agben/Hol-1/ALU/Hol-1-ALU-pcb-v1-0.png

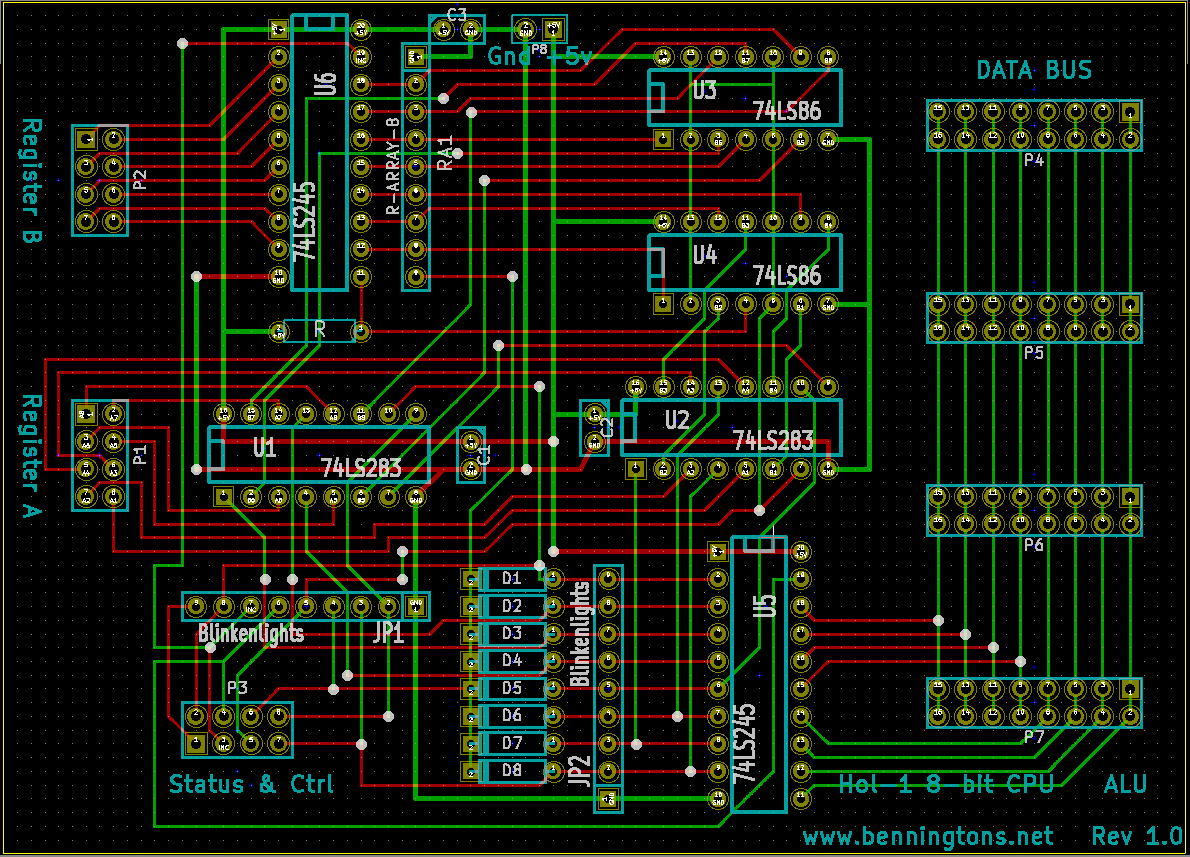
ALU/Hol-1-ALU-pcb-v1-0.png
