agben/Hol-1/MMU/Hol-1-MMU-pcb-v1-0.png

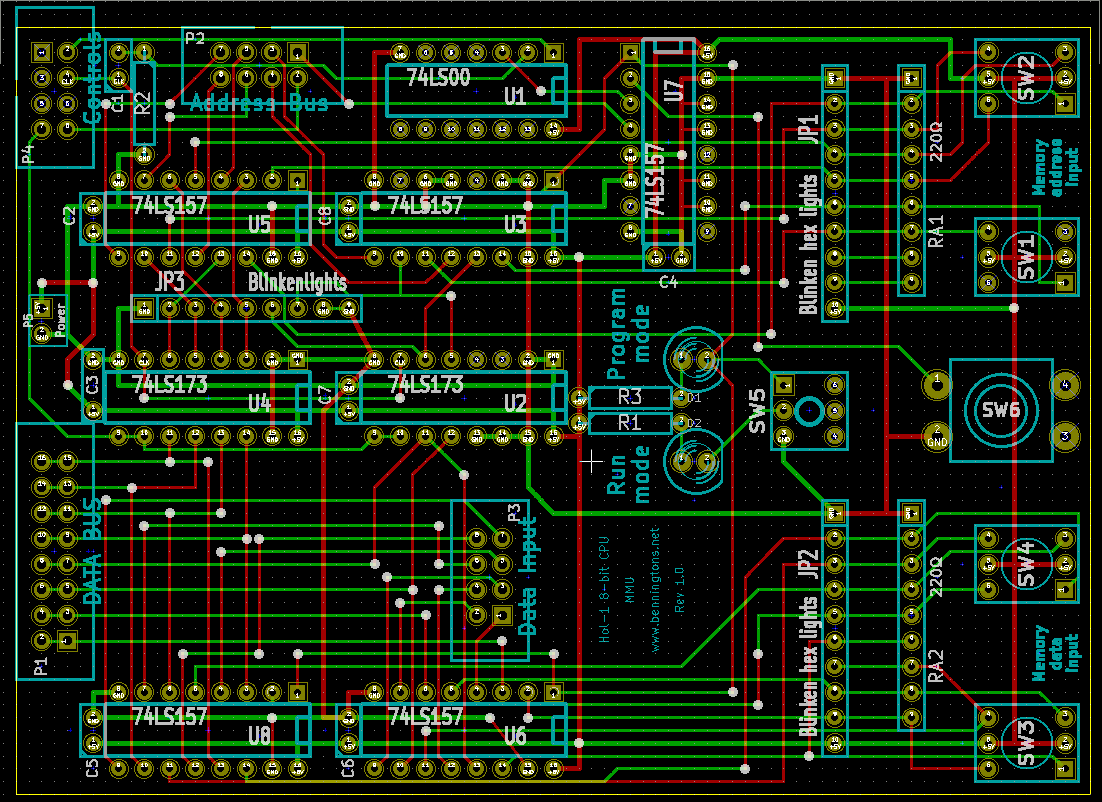
MMU/Hol-1-MMU-pcb-v1-0.png
