agben/Hol-1/RAM/Hol-1-RAM-pcb-v1-0.png

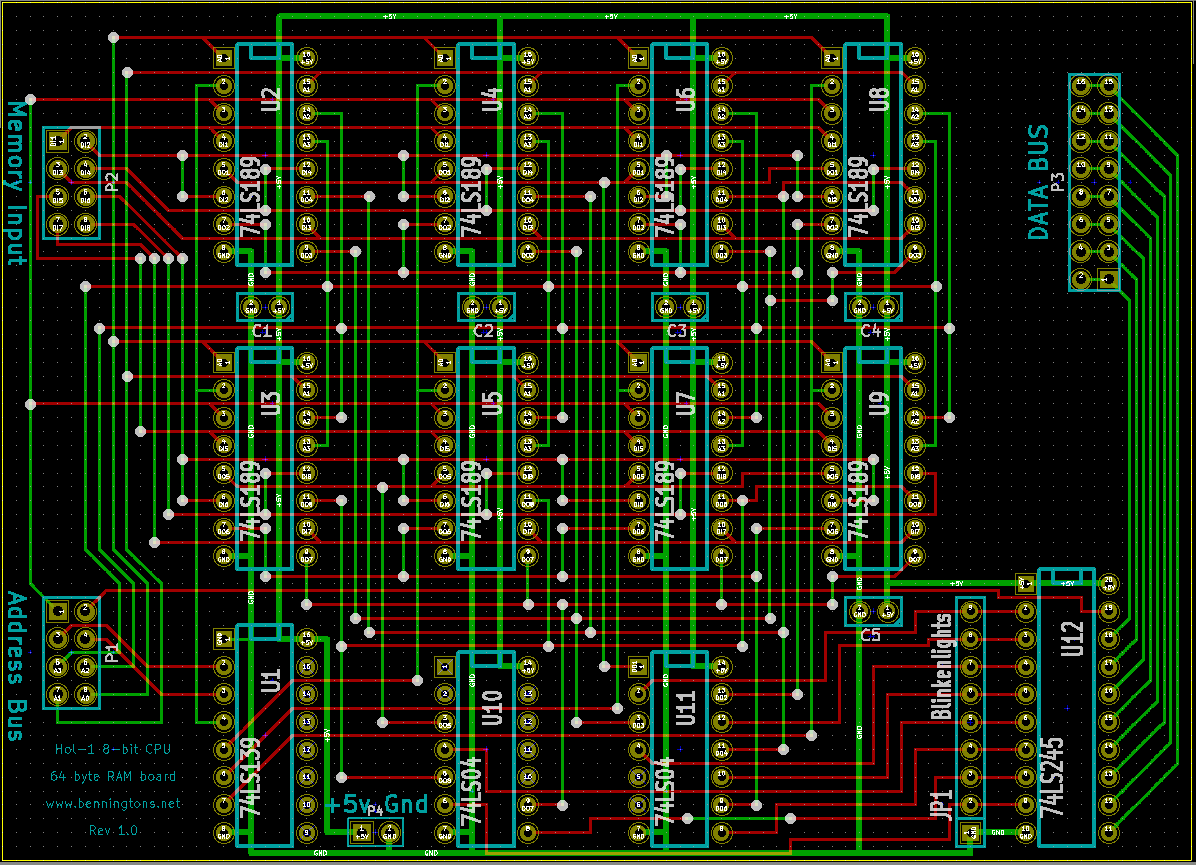
RAM/Hol-1-RAM-pcb-v1-0.png
