agben/Hol-1/RAM/Hol-1-RAM-sch-v1-0.png

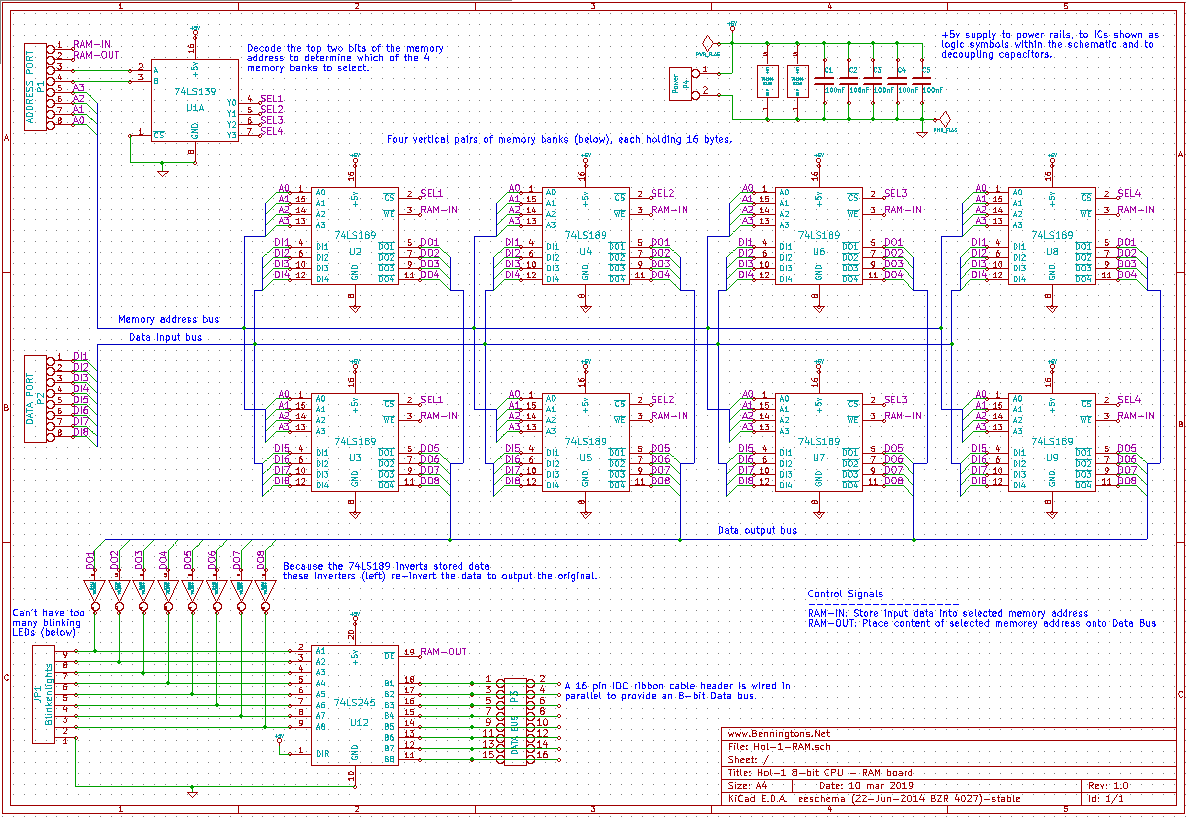
RAM/Hol-1-RAM-sch-v1-0.png
