agben/Hol-1/Registers/Hol-1-Reg-pcb-v1-0.png

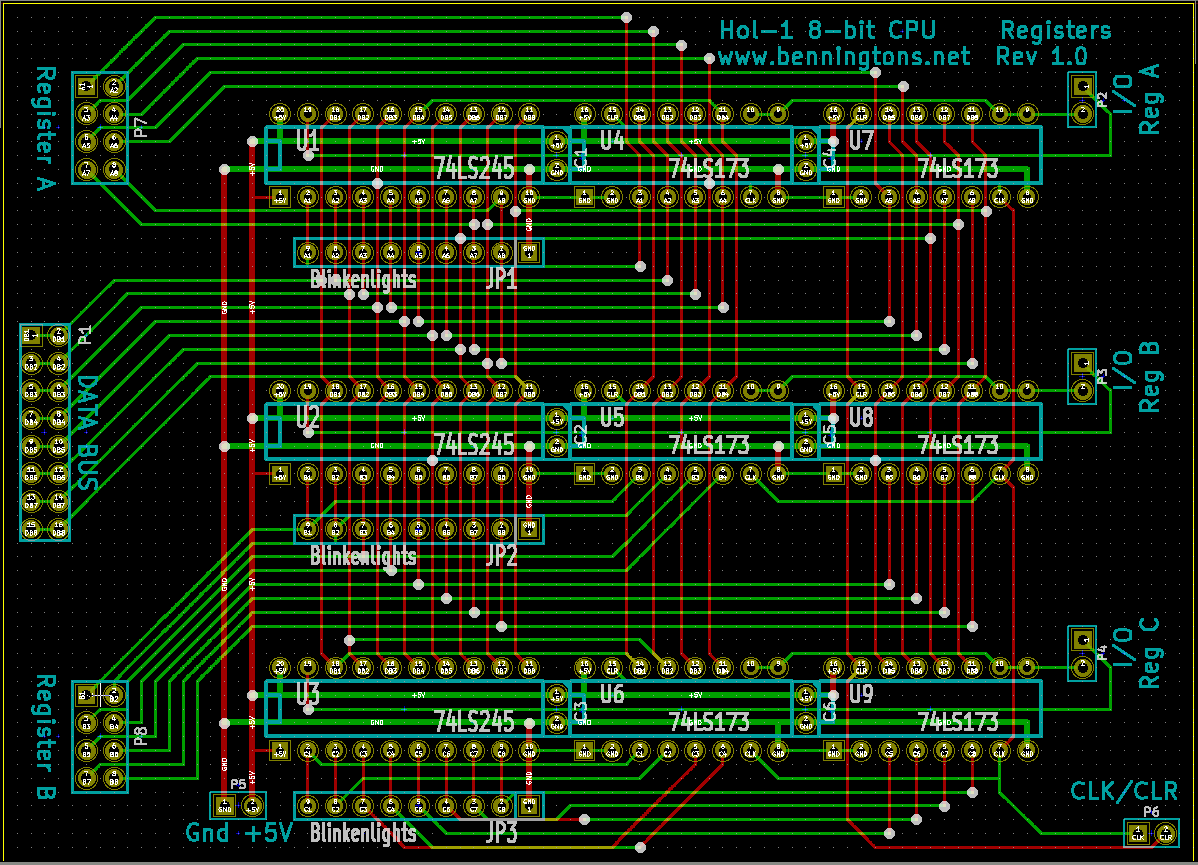
Registers/Hol-1-Reg-pcb-v1-0.png
