agben/Hol-1/Registers/Hol-1-Reg-sch-v1-0.png

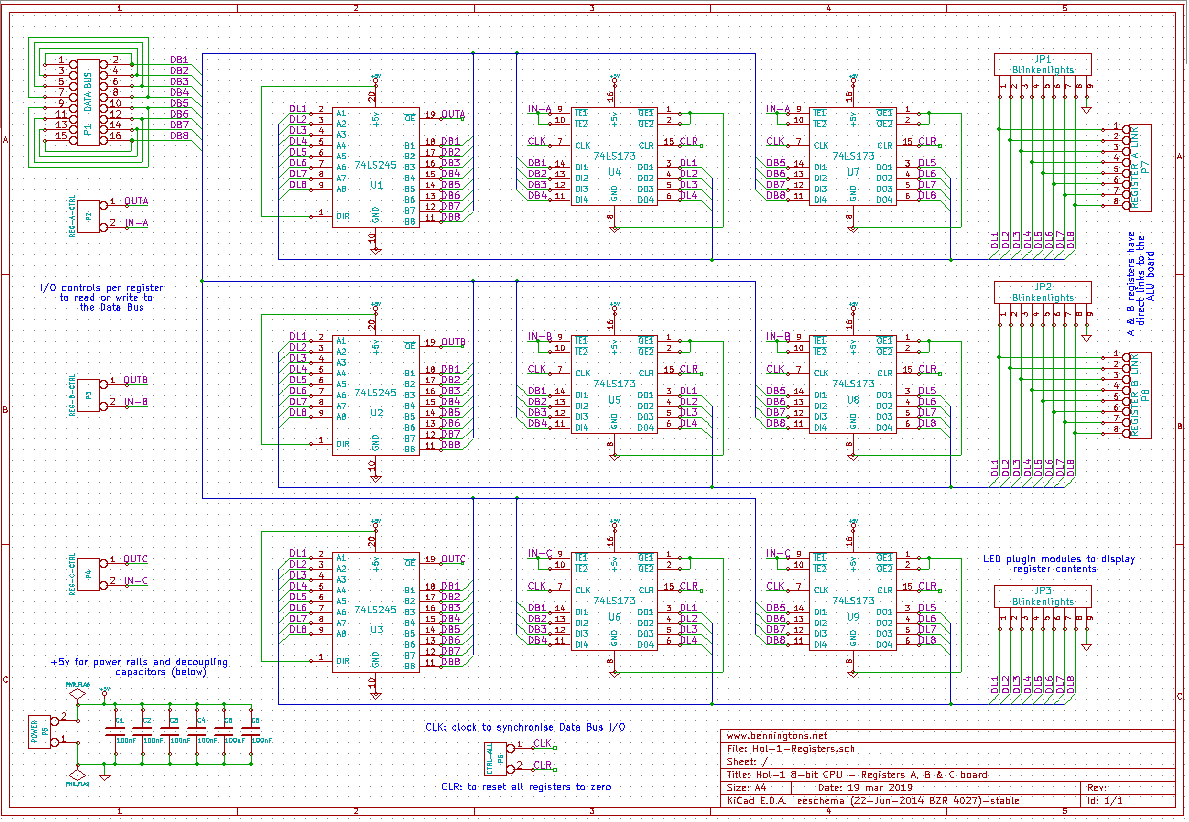
Registers/Hol-1-Reg-sch-v1-0.png
