agben/Hol-1/MMU/Hol-1-MMU.kicad_pcb

## KiCad design MMU/Hol-1-MMU.kicad_pcb (2025-11-22)

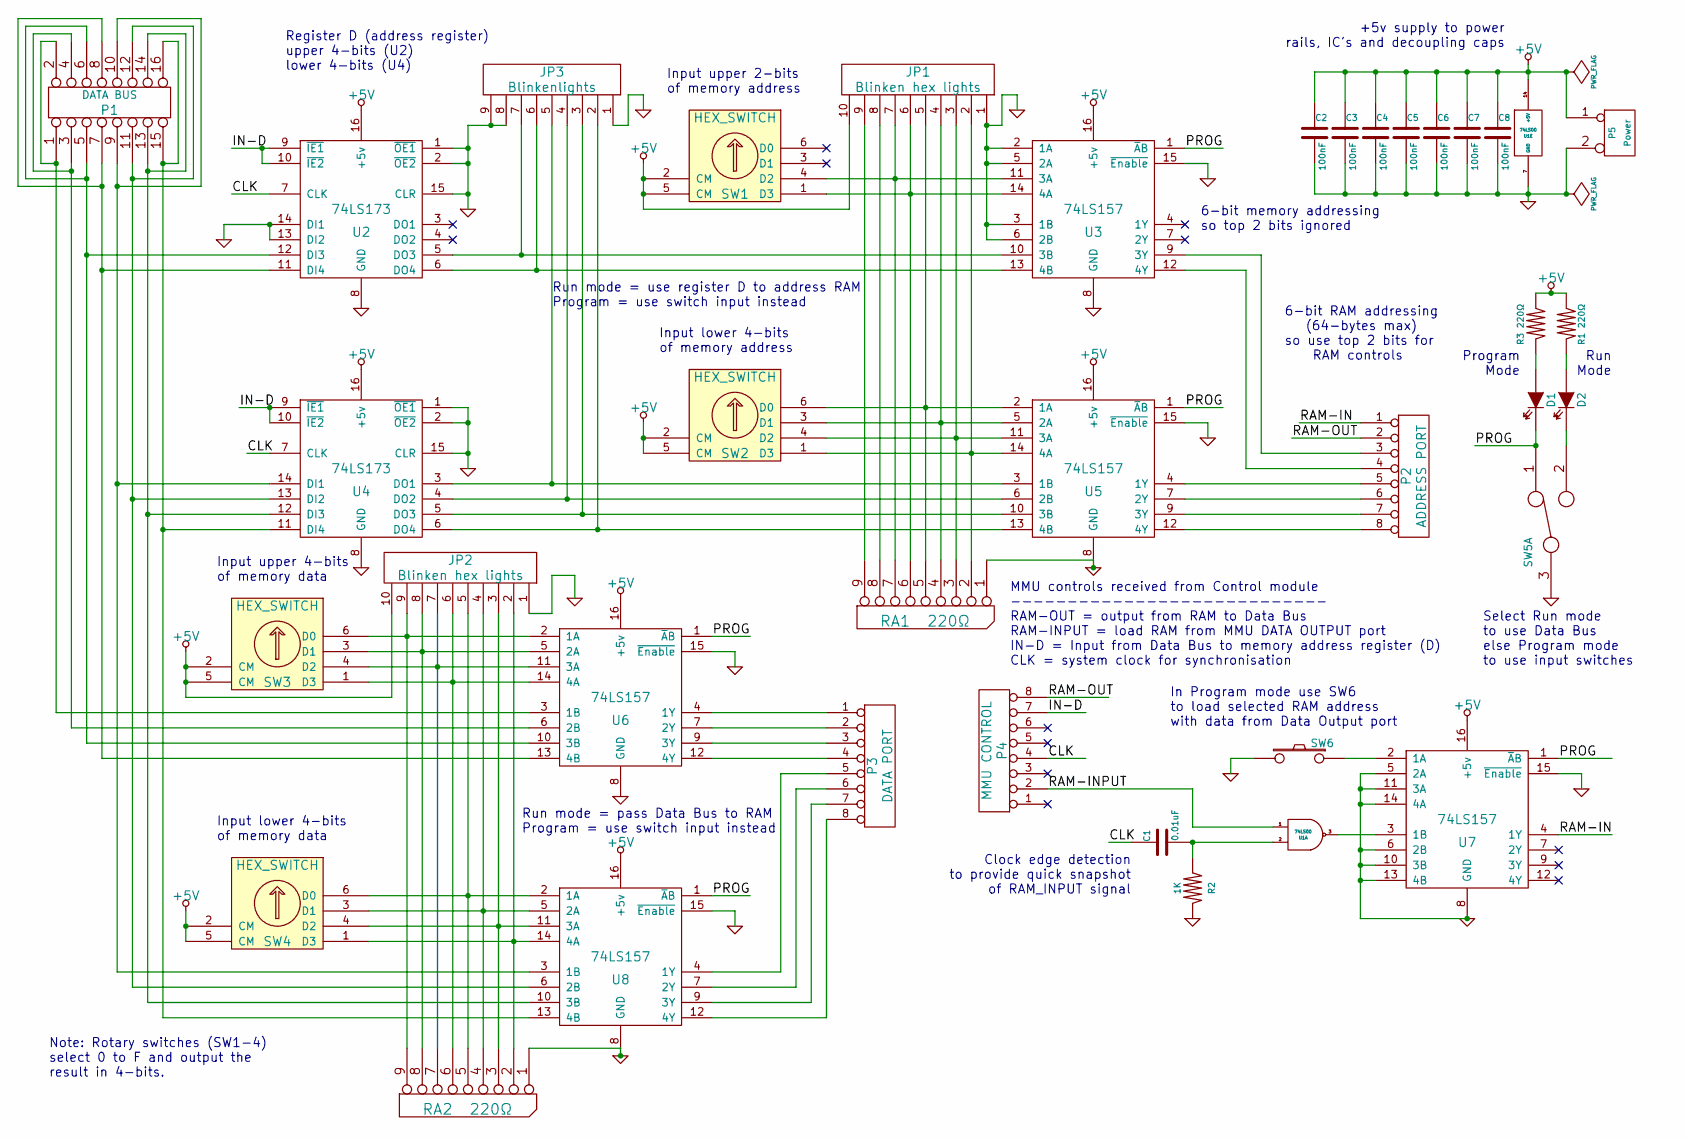
[picture p9: schematic Hol-1-MMU.kicad_sch, Hol-1 8-bit CPU - Memory Management Unit]

Parts:
C1: 0.01uF
C2, C3, C4, C5, C6, C7, C8: 100nF
D1, D2: LED
JP1, JP2: Blinken hex lights
JP3: Blinkenlights
P1: DATA BUS
P2: ADDRESS PORT
P3: DATA PORT
P4: MMU CONTROL
P5: Power
R1, R3: 220Ω
R2: 1K
RA1, RA2: 220Ω
SW1, SW2, SW3, SW4: HEX_SWITCH
SW5: DPDT
SW6: SW_PUSH
U1: 74LS00
U2, U4: 74LS173
U3, U5, U6, U7, U8: 74LS157

Connections:
+5V: C2.1, C3.1, C4.1, C5.1, C6.1, C7.1, C8.1, JP1.10, JP2.10, P5.1, R1.1, R3.1, SW1.2 (CM), SW1.5 (CM), SW2.2 (CM), SW2.5 (CM), SW3.2 (CM), SW3.5 (CM), SW4.2 (CM), SW4.5 (CM), U1.14 (+5V), U2.16 (+5v), U3.16 (+5v), U4.16 (+5v), U5.16 (+5v), U6.16 (+5v), U7.16 (+5v), U8.16 (+5v)
/CLK: C1.1, P4.4, U2.7 (CLK), U4.7 (CLK)
/IN-D: P4.7, U2.9 (~IE1), U2.10 (~IE2), U4.9 (~IE1), U4.10 (~IE2)
/PROG: D1.2 (K), SW5.1, U3.1 (~AB), U5.1 (~AB), U6.1 (~AB), U7.1 (~AB), U8.1 (~AB)
/RAM-IN: P2.1, U7.4 (1Y)
/RAM-INPUT: P4.2, U1.1
/RAM-OUT: P2.2, P4.8
GND: C2.2, C3.2, C4.2, C5.2, C6.2, C7.2, C8.2, JP1.1, JP2.1, JP3.1, JP3.8, JP3.9, P5.2 (PM), R2.2, RA1.1 (COM), RA2.1 (COM), SW5.3, SW6.2, U1.7 (GND), U2.1 (~OE1), U2.2 (~OE2), U2.8 (GND), U2.13 (DI2), U2.14 (DI1), U2.15 (CLR), U3.2 (1A), U3.3 (1B), U3.5 (2A), U3.6 (2B), U3.8 (GND), U3.15 (~Enable), U4.1 (~OE1), U4.2 (~OE2), U4.8 (GND), U4.15 (CLR), U5.8 (GND), U5.15 (~Enable), U6.8 (GND), U6.15 (~Enable), U7.5 (2A), U7.6 (2B), U7.8 (GND), U7.10 (3B), U7.11 (3A), U7.13 (4B), U7.14 (4A), U7.15 (~Enable), U8.8 (GND), U8.15 (~Enable)
unnamed: P2.4, U3.12 (4Y)
unnamed: P2.3, U3.9 (3Y)
unnamed: P1.1, P1.2, U6.3 (1B)
unnamed: P2.5, U5.4 (1Y)
unnamed: D2.2 (K), SW5.2
unnamed: JP2.2, RA2.2, SW4.1 (D3), U8.14 (4A)
unnamed: D1.1 (A), R3.2
unnamed: D2.1 (A), R1.2
unnamed: P2.8, U5.12 (4Y)
unnamed: P2.7, U5.9 (3Y)
unnamed: P2.6, U5.7 (2Y)
unnamed: P3.4, U6.12 (4Y)
unnamed: P3.3, U6.9 (3Y)
unnamed: P3.2, U6.7 (2Y)
unnamed: P1.3, P1.4, U6.6 (2B)
unnamed: JP2.7, RA2.7, SW3.4 (D2), U6.11 (3A)
unnamed: JP2.3, RA2.3, SW4.4 (D2), U8.11 (3A)
unnamed: JP2.4, RA2.4, SW4.3 (D1), U8.5 (2A)
unnamed: JP2.5, RA2.5, SW4.6 (D0), U8.2 (1A)
unnamed: JP2.6, RA2.6, SW3.1 (D3), U6.14 (4A)
unnamed: JP2.8, RA2.8, SW3.3 (D1), U6.5 (2A)
unnamed: JP2.9, RA2.9, SW3.6 (D0), U6.2 (1A)
unnamed: P3.1, U6.4 (1Y)
unnamed: JP3.3, U4.5 (DO3), U5.10 (3B)
unnamed: JP1.8, RA1.8
unnamed: JP1.9, RA1.9
unnamed: JP3.4, U4.4 (DO2), U5.6 (2B)
unnamed: JP3.5, U4.3 (DO1), U5.3 (1B)
unnamed: JP3.6, U2.6 (DO4), U3.13 (4B)
unnamed: JP3.7, U2.5 (DO3), U3.10 (3B)
unnamed: P1.15, P1.16, U4.11 (DI4), U8.13 (4B)
unnamed: P1.13, P1.14, U4.12 (DI3), U8.10 (3B)
unnamed: P1.11, P1.12, U4.13 (DI2), U8.6 (2B)
unnamed: P1.9, P1.10, U4.14 (DI1), U8.3 (1B)
unnamed: JP1.7, RA1.7, SW1.4 (D2), U3.11 (3A)
unnamed: JP1.2, RA1.2, SW2.1 (D3), U5.14 (4A)
unnamed: JP1.3, RA1.3, SW2.4 (D2), U5.11 (3A)
unnamed: JP1.4, RA1.4, SW2.3 (D1), U5.5 (2A)
unnamed: JP1.5, RA1.5, SW2.6 (D0), U5.2 (1A)
unnamed: JP1.6, RA1.6, SW1.1 (D3), U3.14 (4A)
unnamed: JP3.2, U4.6 (DO4), U5.13 (4B)
unnamed: P1.7, P1.8, U2.11 (DI4), U6.13 (4B)
unnamed: P1.5, P1.6, U2.12 (DI3), U6.10 (3B)
unnamed: P3.5, U8.4 (1Y)
unnamed: P3.6, U8.7 (2Y)
unnamed: P3.7, U8.9 (3Y)
unnamed: P3.8, U8.12 (4Y)
unnamed: SW6.1, U7.2 (1A)
unnamed: U1.3, U7.3 (1B)
unnamed: C1.2, R2.1, U1.2

Notes on the sheet:
Select Run mode to use Data Bus else Program mode to use input switches
6-bit memory addressing so top 2 bits ignored
Run mode = pass Data Bus to RAM Program = use switch input instead
Note: Rotary switches (SW1-4) select 0 to F and output the result in 4-bits.
Clock edge detection to provide quick snapshot of RAM_INPUT signal
Register D (address register) upper 4-bits (U2) lower 4-bits (U4)
Run mode = use register D to address RAM Program = use switch input instead
Input lower 4-bits of memory address
MMU controls received from Control module ---------------------------- RAM-OUT = output from RAM to Data Bus RAM-INPUT = load RAM from MMU DATA OUTPUT port IN-D = Input from Data Bus to memory address register (D) CLK = system clock for synchronisation
Input lower 4-bits of memory data
Input upper 2-bits of memory address
+5v supply to power rails, IC's and decoupling caps
Run Mode
In Program mode use SW6 to load selected RAM address with data from Data Output port
Program Mode
Input upper 4-bits of memory data
6-bit RAM addressing (64-bytes max) so use top 2 bits for RAM controls

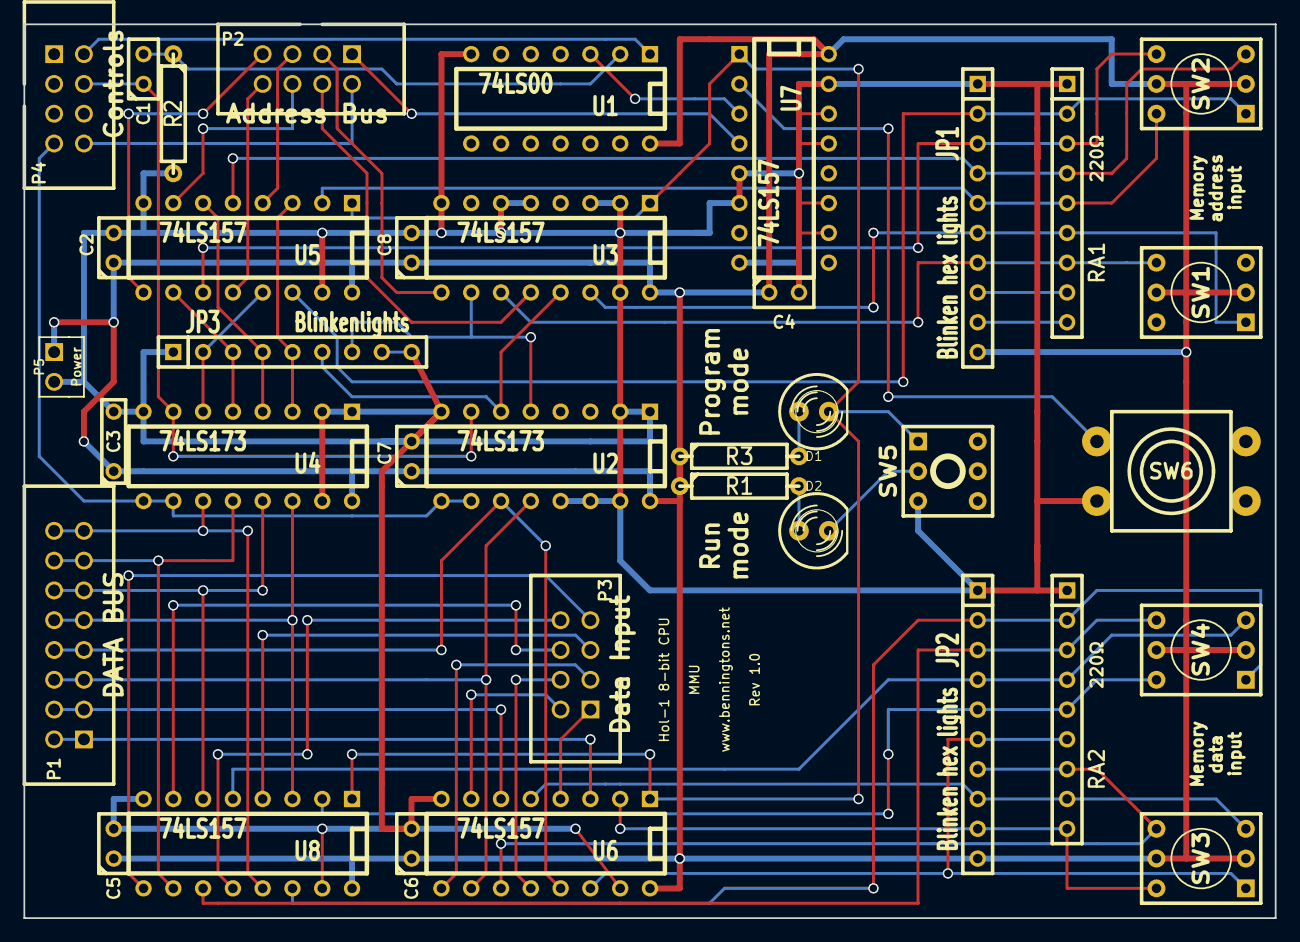
[picture p10: board Hol-1-MMU.kicad_pcb from above]

Board: 2 copper layers, 106.7 x 76.2 mm, 37 parts (0 on the bottom side), 58 nets.
