agben/Hol-1/Registers/Hol-1-Registers.kicad_pcb

## KiCad design Registers/Hol-1-Registers.kicad_pcb (2025-11-22)

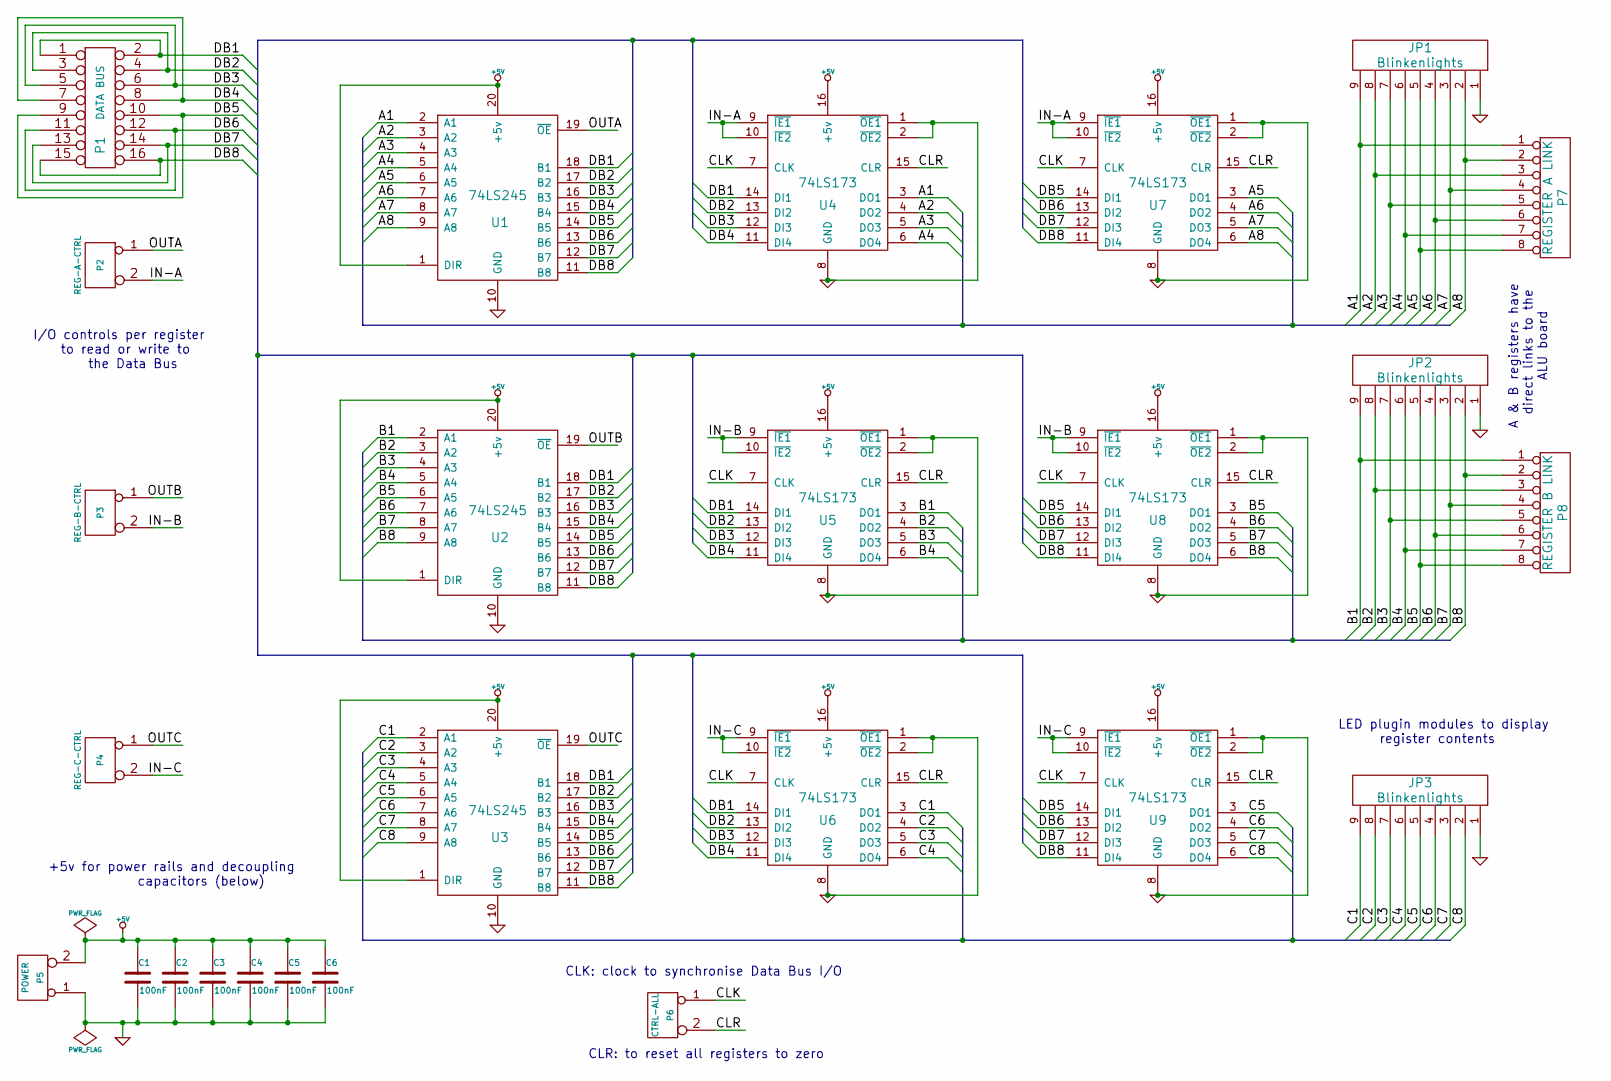
[picture p11: schematic Hol-1-Registers.kicad_sch, Hol-1 8-bit CPU - Registers A, B & C board]

Parts:
C1, C2, C3, C4, C5, C6: 100nF
JP1, JP2, JP3: Blinkenlights
P1: DATA BUS
P2: REG-A-CTRL
P3: REG-B-CTRL
P4: REG-C-CTRL
P5: POWER
P6: CTRL-ALL
P7: REGISTER A LINK
P8: REGISTER B LINK
U1, U2, U3: 74LS245
U4, U5, U6, U7, U8, U9: 74LS173

Connections:
+5V: C1.1, C2.1, C3.1, C4.1, C5.1, C6.1, P5.2 (PM), U1.1 (DIR), U1.20 (+5v), U2.1 (DIR), U2.20 (+5v), U3.1 (DIR), U3.20 (+5v), U4.16 (+5v), U5.16 (+5v), U6.16 (+5v), U7.16 (+5v), U8.16 (+5v), U9.16 (+5v)
/A1: JP1.9, P7.1, U1.2 (A1), U4.3 (DO1)
/A2: JP1.8, P7.3, U1.3 (A2), U4.4 (DO2)
/A3: JP1.7, P7.5, U1.4 (A3), U4.5 (DO3)
/A4: JP1.6, P7.7, U1.5 (A4), U4.6 (DO4)
/A5: JP1.5, P7.8, U1.6 (A5), U7.3 (DO1)
/A6: JP1.4, P7.6, U1.7 (A6), U7.4 (DO2)
/A7: JP1.3, P7.4, U1.8 (A7), U7.5 (DO3)
/A8: JP1.2, P7.2, U1.9 (A8), U7.6 (DO4)
/B1: JP2.9, P8.1, U2.2 (A1), U5.3 (DO1)
/B2: JP2.8, P8.3, U2.3 (A2), U5.4 (DO2)
/B3: JP2.7, P8.5, U2.4 (A3), U5.5 (DO3)
/B4: JP2.6, P8.7, U2.5 (A4), U5.6 (DO4)
/B5: JP2.5, P8.8, U2.6 (A5), U8.3 (DO1)
/B6: JP2.4, P8.6, U2.7 (A6), U8.4 (DO2)
/B7: JP2.3, P8.4, U2.8 (A7), U8.5 (DO3)
/B8: JP2.2, P8.2, U2.9 (A8), U8.6 (DO4)
/C1: JP3.9, U3.2 (A1), U6.3 (DO1)
/C2: JP3.8, U3.3 (A2), U6.4 (DO2)
/C3: JP3.7, U3.4 (A3), U6.5 (DO3)
/C4: JP3.6, U3.5 (A4), U6.6 (DO4)
/C5: JP3.5, U3.6 (A5), U9.3 (DO1)
/C6: JP3.4, U3.7 (A6), U9.4 (DO2)
/C7: JP3.3, U3.8 (A7), U9.5 (DO3)
/C8: JP3.2, U3.9 (A8), U9.6 (DO4)
/CLK: P6.1, U4.7 (CLK), U5.7 (CLK), U6.7 (CLK), U7.7 (CLK), U8.7 (CLK), U9.7 (CLK)
/CLR: P6.2 (PM), U4.15 (CLR), U5.15 (CLR), U6.15 (CLR), U7.15 (CLR), U8.15 (CLR), U9.15 (CLR)
/DB1: P1.1, P1.2, U1.18 (B1), U2.18 (B1), U3.18 (B1), U4.14 (DI1), U5.14 (DI1), U6.14 (DI1)
/DB2: P1.3, P1.4, U1.17 (B2), U2.17 (B2), U3.17 (B2), U4.13 (DI2), U5.13 (DI2), U6.13 (DI2)
/DB3: P1.5, P1.6, U1.16 (B3), U2.16 (B3), U3.16 (B3), U4.12 (DI3), U5.12 (DI3), U6.12 (DI3)
/DB4: P1.7, P1.8, U1.15 (B4), U2.15 (B4), U3.15 (B4), U4.11 (DI4), U5.11 (DI4), U6.11 (DI4)
/DB5: P1.9, P1.10, U1.14 (B5), U2.14 (B5), U3.14 (B5), U7.14 (DI1), U8.14 (DI1), U9.14 (DI1)
/DB6: P1.11, P1.12, U1.13 (B6), U2.13 (B6), U3.13 (B6), U7.13 (DI2), U8.13 (DI2), U9.13 (DI2)
/DB7: P1.13, P1.14, U1.12 (B7), U2.12 (B7), U3.12 (B7), U7.12 (DI3), U8.12 (DI3), U9.12 (DI3)
/DB8: P1.15, P1.16, U1.11 (B8), U2.11 (B8), U3.11 (B8), U7.11 (DI4), U8.11 (DI4), U9.11 (DI4)
/IN-A: P2.2 (PM), U4.9 (~IE1), U4.10 (~IE2), U7.9 (~IE1), U7.10 (~IE2)
/IN-B: P3.2 (PM), U5.9 (~IE1), U5.10 (~IE2), U8.9 (~IE1), U8.10 (~IE2)
/IN-C: P4.2 (PM), U6.9 (~IE1), U6.10 (~IE2), U9.9 (~IE1), U9.10 (~IE2)
/OUTA: P2.1, U1.19 (~OE)
/OUTB: P3.1, U2.19 (~OE)
/OUTC: P4.1, U3.19 (~OE)
GND: C1.2, C2.2, C3.2, C4.2, C5.2, C6.2, JP1.1, JP2.1, JP3.1, P5.1, U1.10 (GND), U2.10 (GND), U3.10 (GND), U4.1 (~OE1), U4.2 (~OE2), U4.8 (GND), U5.1 (~OE1), U5.2 (~OE2), U5.8 (GND), U6.1 (~OE1), U6.2 (~OE2), U6.8 (GND), U7.1 (~OE1), U7.2 (~OE2), U7.8 (GND), U8.1 (~OE1), U8.2 (~OE2), U8.8 (GND), U9.1 (~OE1), U9.2 (~OE2), U9.8 (GND)

Notes on the sheet:
CLR: to reset all registers to zero
A & B registers have direct links to the ALU board
CLK: clock to synchronise Data Bus I/O
+5v for power rails and decoupling capacitors (below)
LED plugin modules to display register contents
I/O controls per register to read or write to the Data Bus

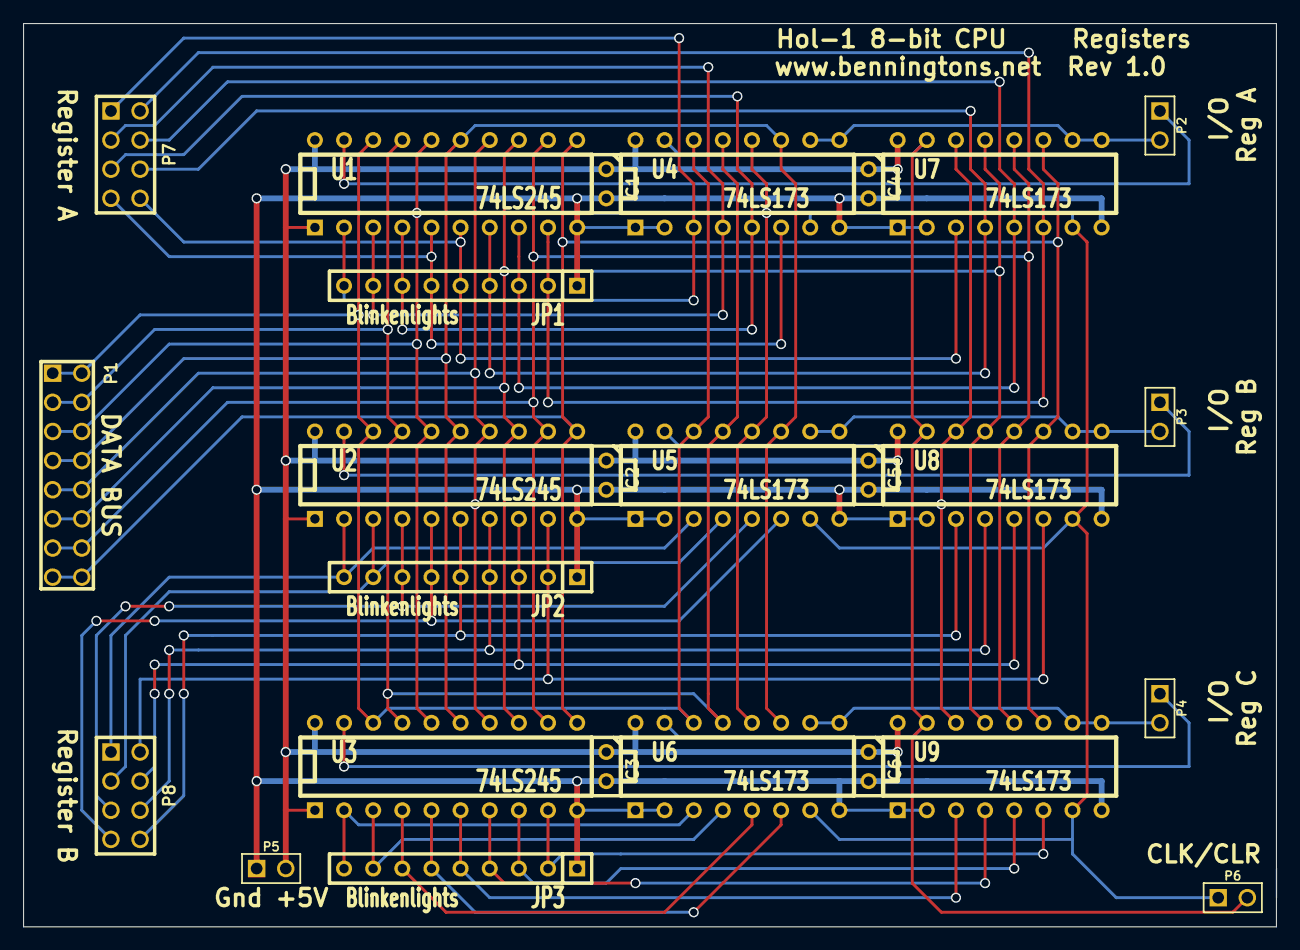
[picture p12: board Hol-1-Registers.kicad_pcb from above]

Board: 2 copper layers, 109.2 x 78.7 mm, 26 parts (0 on the bottom side), 42 nets.
