agben/Hol-1/Clock/Hol-1-Clock.kicad_pcb

## KiCad design Clock/Hol-1-Clock.kicad_pcb (2025-11-22)

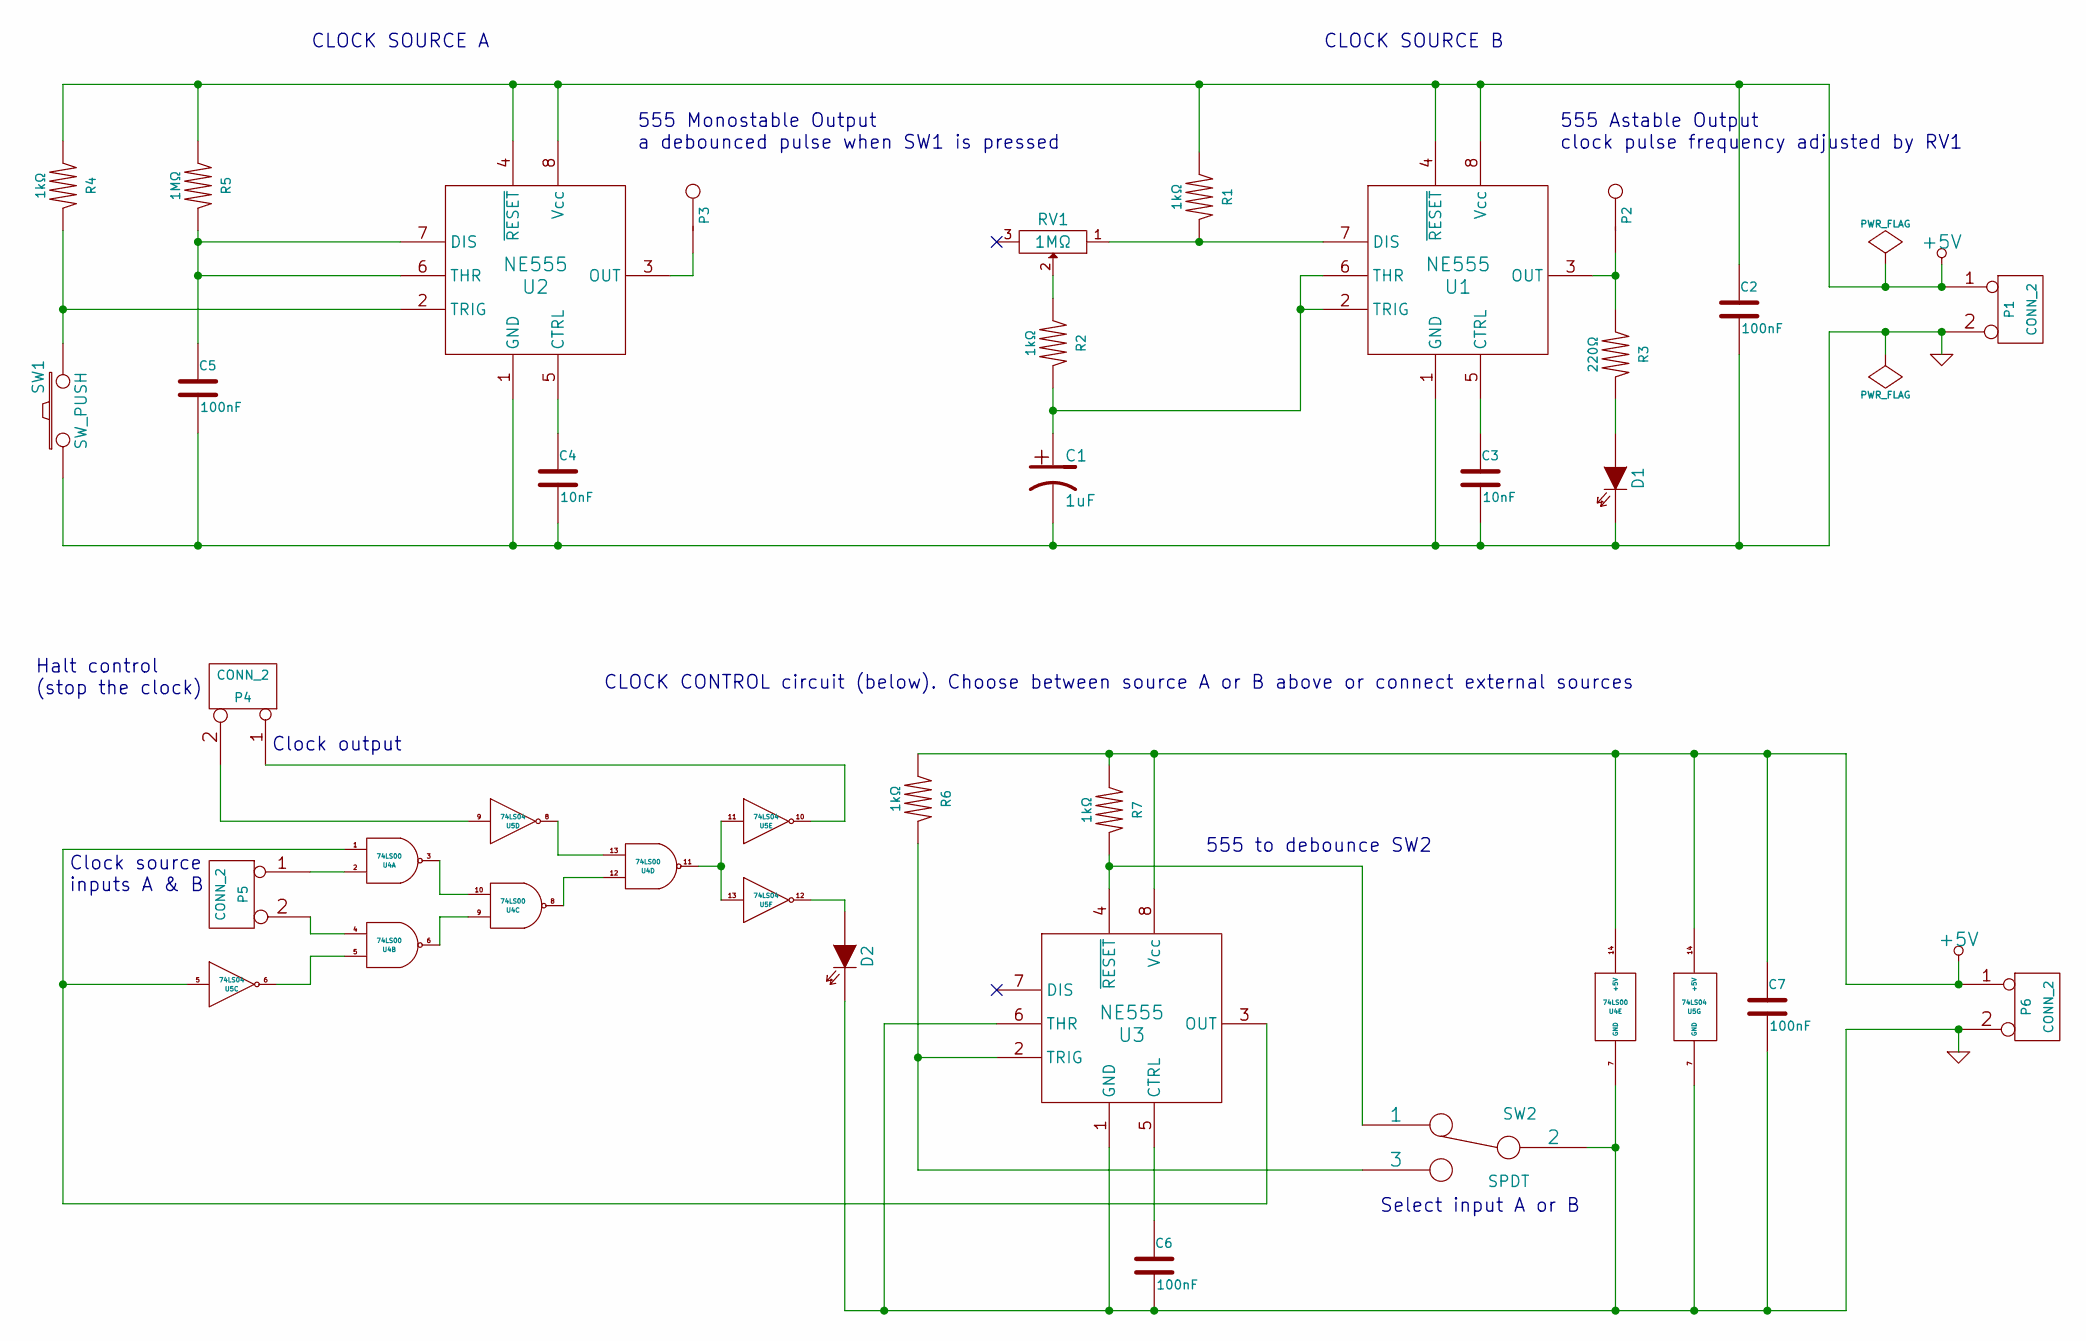
[picture p13: schematic Hol-1-Clock.kicad_sch, Hol-1 8-bit CPU clock source & selection]

Parts:
C1: 1uF
C2, C5, C6, C7: 100nF
C3, C4: 10nF
D1, D2: LED
P1, P4, P5, P6: CONN_2
P2, P3: CONN_1
R1, R2, R4, R6, R7: 1kΩ
R3: 220Ω
R5: 1MΩ
RV1: 1MΩ
SW1: SW_PUSH
SW2: SPDT
U1, U2, U3: NE555
U4: 74LS00
U5: 74LS04

Connections:
+5V: C2.1, C7.1, P1.1, P6.1, R1.1, R4.1, R5.1, R6.1, R7.1, U1.4 (~RESET), U1.8 (Vcc), U2.4 (~RESET), U2.8 (Vcc), U3.8 (Vcc), U4.14 (+5V), U5.14 (+5V)
GND: C1.2, C2.2, C3.2, C4.2, C5.2, C6.2, C7.2, D1.2 (K), D2.2 (K), P1.2 (PM), P6.2 (PM), SW1.1, SW2.2, U1.1 (GND), U2.1 (GND), U3.1 (GND), U3.6 (THR), U4.7 (GND), U5.7 (GND)
unnamed: C5.1, R5.2, U2.6 (THR), U2.7 (DIS)
unnamed: R4.2, SW1.2, U2.2 (TRIG)
unnamed: C6.1, U3.5 (CTRL)
unnamed: D1.1 (A), R3.2
unnamed: P2.1, R3.1, U1.3 (OUT)
unnamed: C3.1, U1.5 (CTRL)
unnamed: R2.1, RV1.2
unnamed: P3.1, U2.3 (OUT)
unnamed: C4.1, U2.5 (CTRL)
unnamed: P5.2 (PM), U4.4
unnamed: U4.5, U5.6
unnamed: P4.2 (PM), U5.9
unnamed: R7.2, SW2.1, U3.4 (~RESET)
unnamed: P5.1, U4.2
unnamed: D2.1 (A), U5.12
unnamed: P4.1, U5.10
unnamed: U4.11, U5.11, U5.13
unnamed: R6.2, SW2.3, U3.2 (TRIG)
unnamed: U4.13, U5.8
unnamed: U4.8, U4.12
unnamed: U4.3, U4.10
unnamed: U4.6, U4.9
unnamed: U3.3 (OUT), U4.1, U5.5
unnamed: R1.2, RV1.1, U1.7 (DIS)
unnamed: C1.1, R2.2, U1.2 (TRIG), U1.6 (THR)

Notes on the sheet:
Select input A or B
CLOCK SOURCE A
CLOCK SOURCE B
555 Monostable Output a debounced pulse when SW1 is pressed
555 Astable Output clock pulse frequency adjusted by RV1
Halt control (stop the clock)
CLOCK CONTROL circuit (below). Choose between source A or B above or connect external sources
555 to debounce SW2
Clock source inputs A & B
Clock output

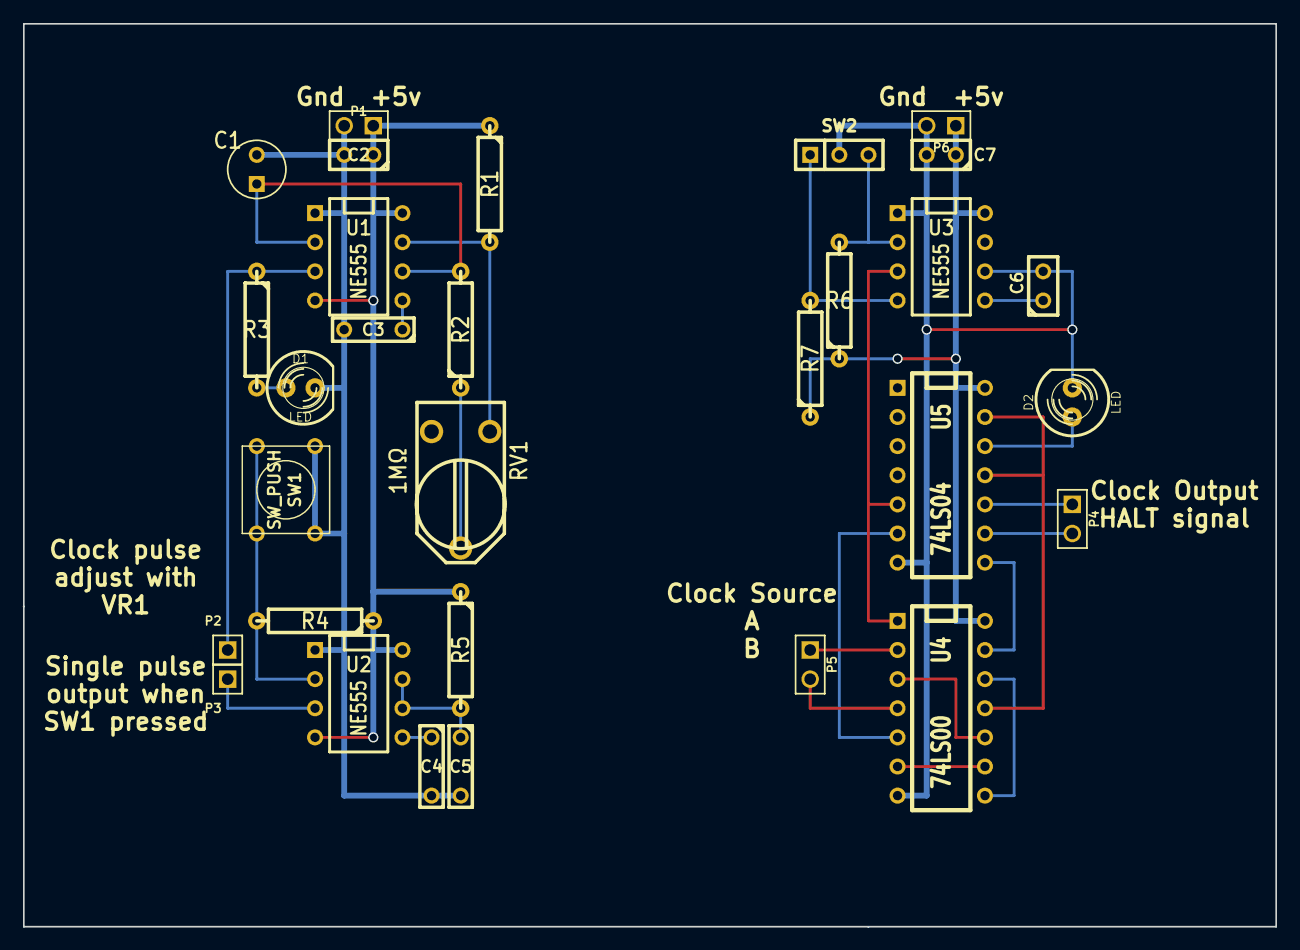
[picture p14: board Hol-1-Clock.kicad_pcb from above]

Board: 2 copper layers, 109.2 x 78.7 mm, 30 parts (0 on the bottom side), 27 nets.
