agben/Hol-1/RAM/Hol-1-RAM.kicad_pcb

## KiCad design RAM/Hol-1-RAM.kicad_pcb (2025-11-22)

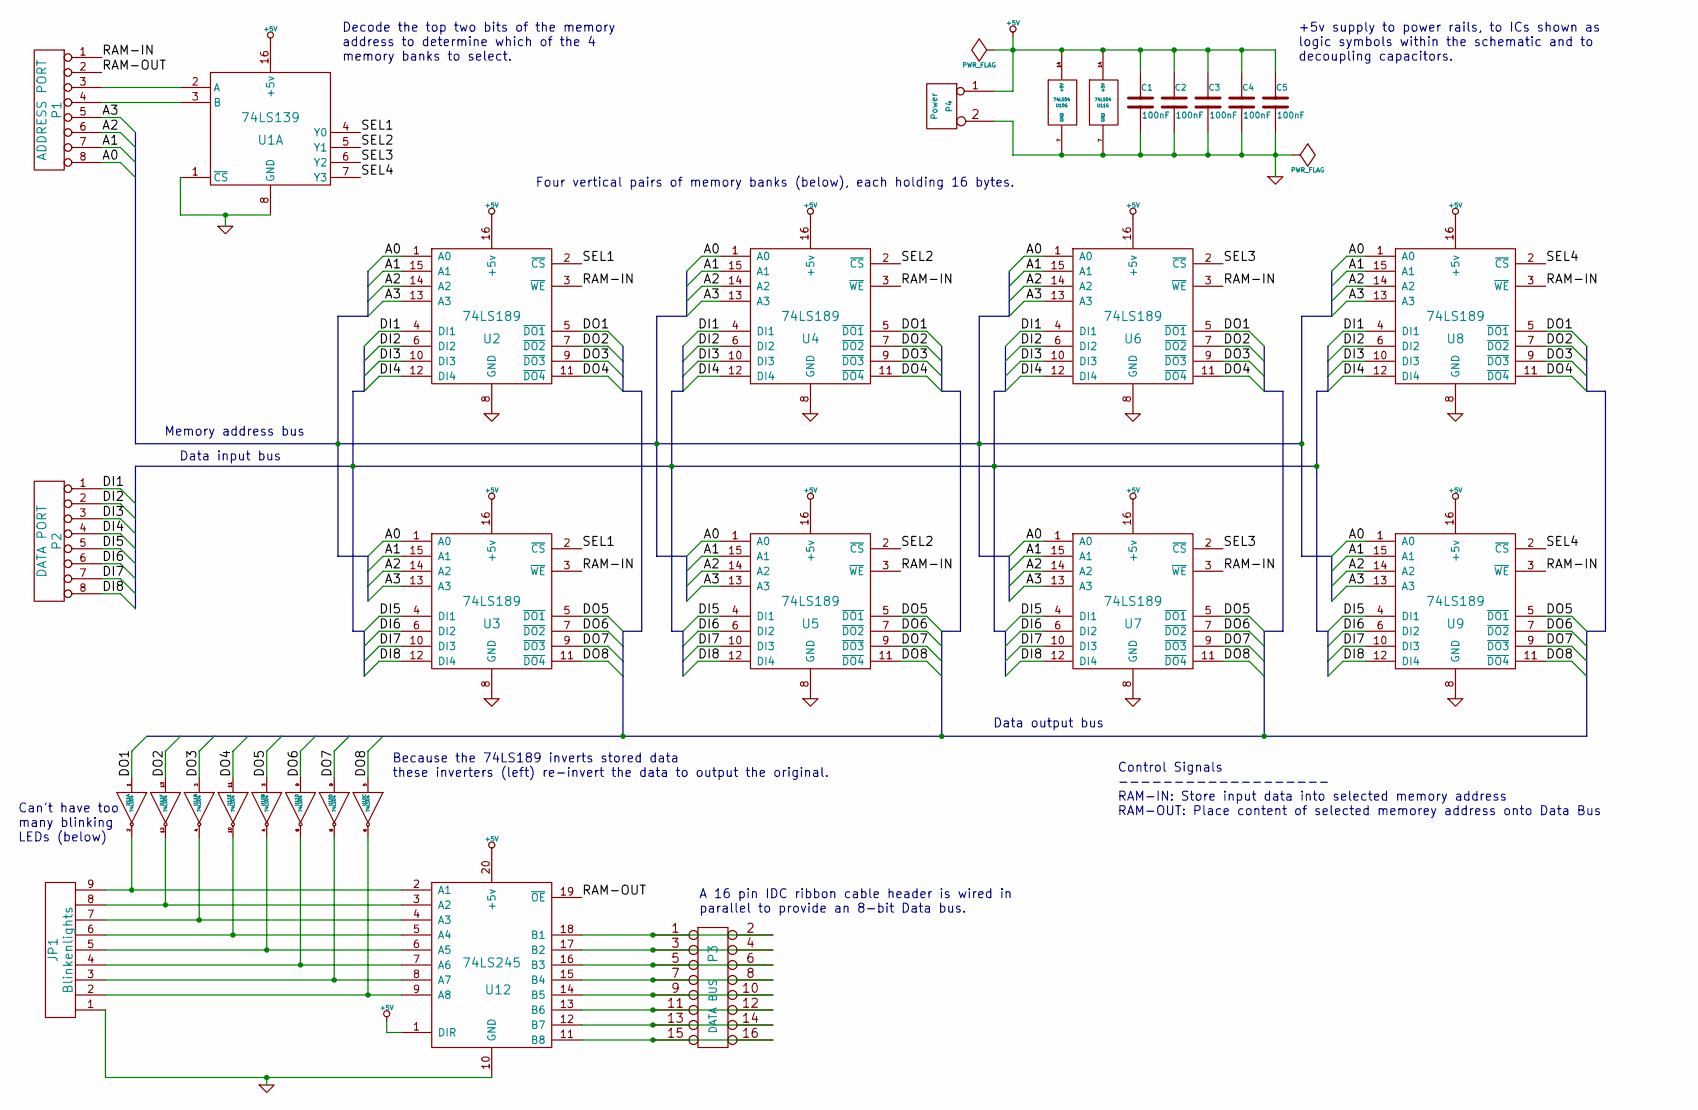
[picture p15: schematic Hol-1-RAM.kicad_sch, Hol-1 8-bit CPU - RAM board]

Parts:
C1, C2, C3, C4, C5: 100nF
JP1: Blinkenlights
P1: ADDRESS PORT
P2: DATA PORT
P3: DATA BUS
P4: Power
U1: 74LS139
U2, U3, U4, U5, U6, U7, U8, U9: 74LS189
U10, U11: 74LS04
U12: 74LS245

Connections:
+5V: C1.1, C2.1, C3.1, C4.1, C5.1, P4.1, U1.16 (+5v), U2.16 (+5v), U3.16 (+5v), U4.16 (+5v), U5.16 (+5v), U6.16 (+5v), U7.16 (+5v), U8.16 (+5v), U9.16 (+5v), U10.14 (+5V), U11.14 (+5V), U12.1 (DIR), U12.20 (+5v)
/A0: P1.8, U2.1 (A0), U3.1 (A0), U4.1 (A0), U5.1 (A0), U6.1 (A0), U7.1 (A0), U8.1 (A0), U9.1 (A0)
/A1: P1.7, U2.15 (A1), U3.15 (A1), U4.15 (A1), U5.15 (A1), U6.15 (A1), U7.15 (A1), U8.15 (A1), U9.15 (A1)
/A2: P1.6, U2.14 (A2), U3.14 (A2), U4.14 (A2), U5.14 (A2), U6.14 (A2), U7.14 (A2), U8.14 (A2), U9.14 (A2)
/A3: P1.5, U2.13 (A3), U3.13 (A3), U4.13 (A3), U5.13 (A3), U6.13 (A3), U7.13 (A3), U8.13 (A3), U9.13 (A3)
/DI1: P2.1, U2.4 (DI1), U4.4 (DI1), U6.4 (DI1), U8.4 (DI1)
/DI2: P2.2, U2.6 (DI2), U4.6 (DI2), U6.6 (DI2), U8.6 (DI2)
/DI3: P2.3, U2.10 (DI3), U4.10 (DI3), U6.10 (DI3), U8.10 (DI3)
/DI4: P2.4, U2.12 (DI4), U4.12 (DI4), U6.12 (DI4), U8.12 (DI4)
/DI5: P2.5, U3.4 (DI1), U5.4 (DI1), U7.4 (DI1), U9.4 (DI1)
/DI6: P2.6, U3.6 (DI2), U5.6 (DI2), U7.6 (DI2), U9.6 (DI2)
/DI7: P2.7, U3.10 (DI3), U5.10 (DI3), U7.10 (DI3), U9.10 (DI3)
/DI8: P2.8, U3.12 (DI4), U5.12 (DI4), U7.12 (DI4), U9.12 (DI4)
/DO1: U2.5 (~DO1), U4.5 (~DO1), U6.5 (~DO1), U8.5 (~DO1), U11.1
/DO2: U2.7 (~DO2), U4.7 (~DO2), U6.7 (~DO2), U8.7 (~DO2), U11.13
/DO3: U2.9 (~DO3), U4.9 (~DO3), U6.9 (~DO3), U8.9 (~DO3), U11.3
/DO4: U2.11 (~DO4), U4.11 (~DO4), U6.11 (~DO4), U8.11 (~DO4), U11.11
/DO5: U3.5 (~DO1), U5.5 (~DO1), U7.5 (~DO1), U9.5 (~DO1), U10.3
/DO6: U3.7 (~DO2), U5.7 (~DO2), U7.7 (~DO2), U9.7 (~DO2), U11.9
/DO7: U3.9 (~DO3), U5.9 (~DO3), U7.9 (~DO3), U9.9 (~DO3), U10.9
/DO8: U3.11 (~DO4), U5.11 (~DO4), U7.11 (~DO4), U9.11 (~DO4), U10.5
/RAM-IN: P1.1, U2.3 (~WE), U3.3 (~WE), U4.3 (~WE), U5.3 (~WE), U6.3 (~WE), U7.3 (~WE), U8.3 (~WE), U9.3 (~WE)
/RAM-OUT: P1.2, U12.19 (~OE)
/SEL1: U1.4 (Y0), U2.2 (~CS), U3.2 (~CS)
/SEL2: U1.5 (Y1), U4.2 (~CS), U5.2 (~CS)
/SEL3: U1.6 (Y2), U6.2 (~CS), U7.2 (~CS)
/SEL4: U1.7 (Y3), U8.2 (~CS), U9.2 (~CS)
GND: C1.2, C2.2, C3.2, C4.2, C5.2, JP1.1, P4.2 (PM), U1.1 (~CS), U1.8 (GND), U2.8 (GND), U3.8 (GND), U4.8 (GND), U5.8 (GND), U6.8 (GND), U7.8 (GND), U8.8 (GND), U9.8 (GND), U10.7 (GND), U11.7 (GND), U12.10 (GND)
unnamed: JP1.5, U10.4, U12.6 (A5)
unnamed: JP1.4, U11.8, U12.7 (A6)
unnamed: JP1.3, U10.8, U12.8 (A7)
unnamed: JP1.2, U10.6, U12.9 (A8)
unnamed: JP1.6, U11.10, U12.5 (A4)
unnamed: JP1.7, U11.4, U12.4 (A3)
unnamed: JP1.8, U11.12, U12.3 (A2)
unnamed: JP1.9, U11.2, U12.2 (A1)
unnamed: P3.9, P3.10, U12.14 (B5)
unnamed: P3.11, P3.12, U12.13 (B6)
unnamed: P3.13, P3.14, U12.12 (B7)
unnamed: P3.15, P3.16, U12.11 (B8)
unnamed: P3.7, P3.8, U12.15 (B4)
unnamed: P1.3, U1.2 (A)
unnamed: P1.4, U1.3 (B)
unnamed: P3.1, P3.2, U12.18 (B1)
unnamed: P3.3, P3.4, U12.17 (B2)
unnamed: P3.5, P3.6, U12.16 (B3)

Notes on the sheet:
Decode the top two bits of the memory address to determine which of the 4 memory banks to select.
Data input bus
A 16 pin IDC ribbon cable header is wired in parallel to provide an 8-bit Data bus.
Memory address bus
Data output bus
Four vertical pairs of memory banks (below), each holding 16 bytes.
Because the 74LS189 inverts stored data these inverters (left) re-invert the data to output the original.
Control Signals ------------------- RAM-IN: Store input data into selected memory address RAM-OUT: Place content of selected memorey address onto Data Bus
+5v supply to power rails, to ICs shown as logic symbols within the schematic and to decoupling capacitors.
Can't have too many blinking LEDs (below)

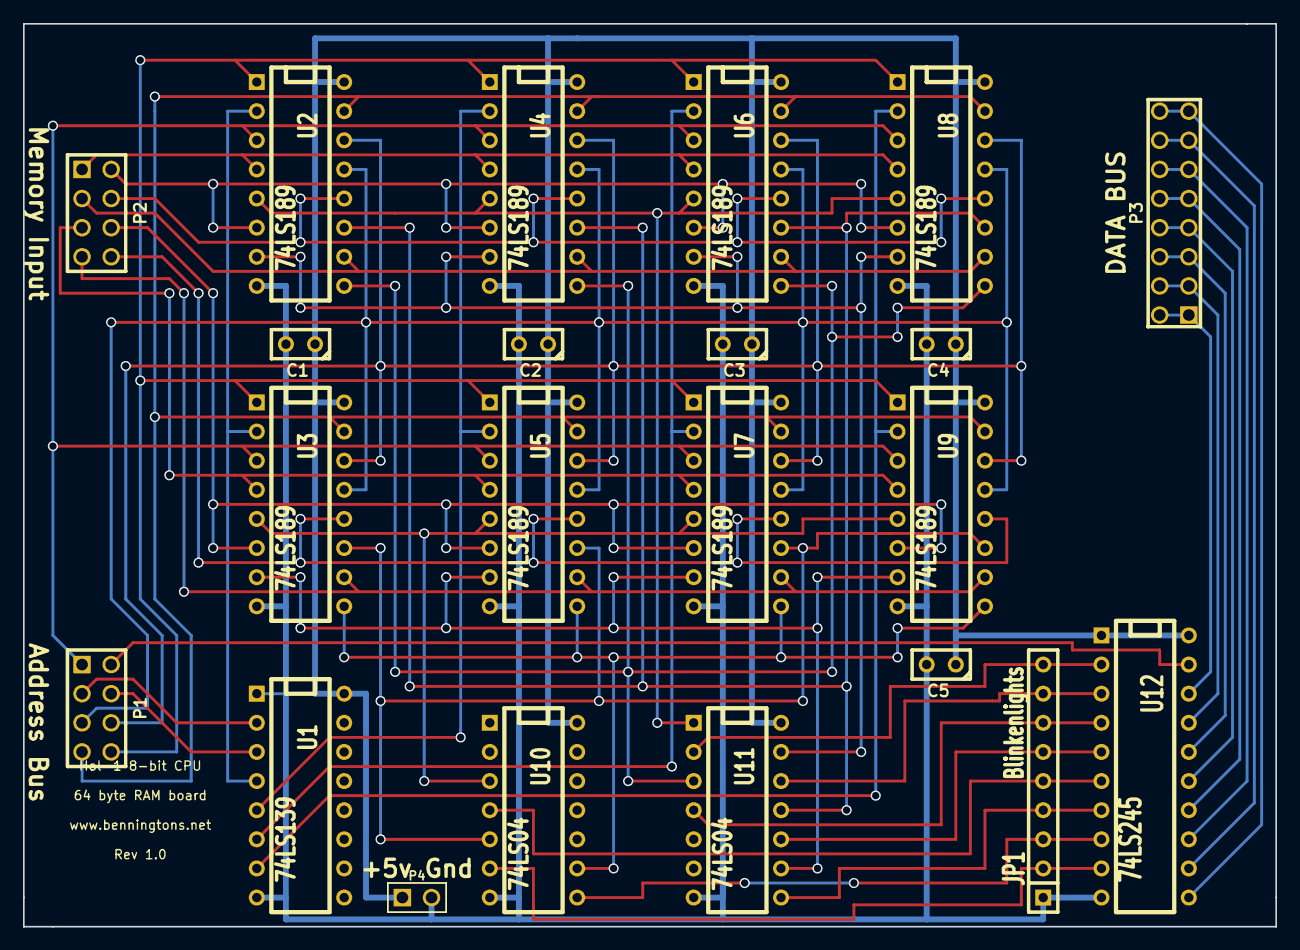
[picture p16: board Hol-1-RAM.kicad_pcb from above]

Board: 2 copper layers, 109.2 x 78.7 mm, 22 parts (0 on the bottom side), 46 nets.
