agben/Hol-1/ALU/Hol-1-ALU.kicad_pcb

## KiCad design ALU/Hol-1-ALU.kicad_pcb (2025-11-22)

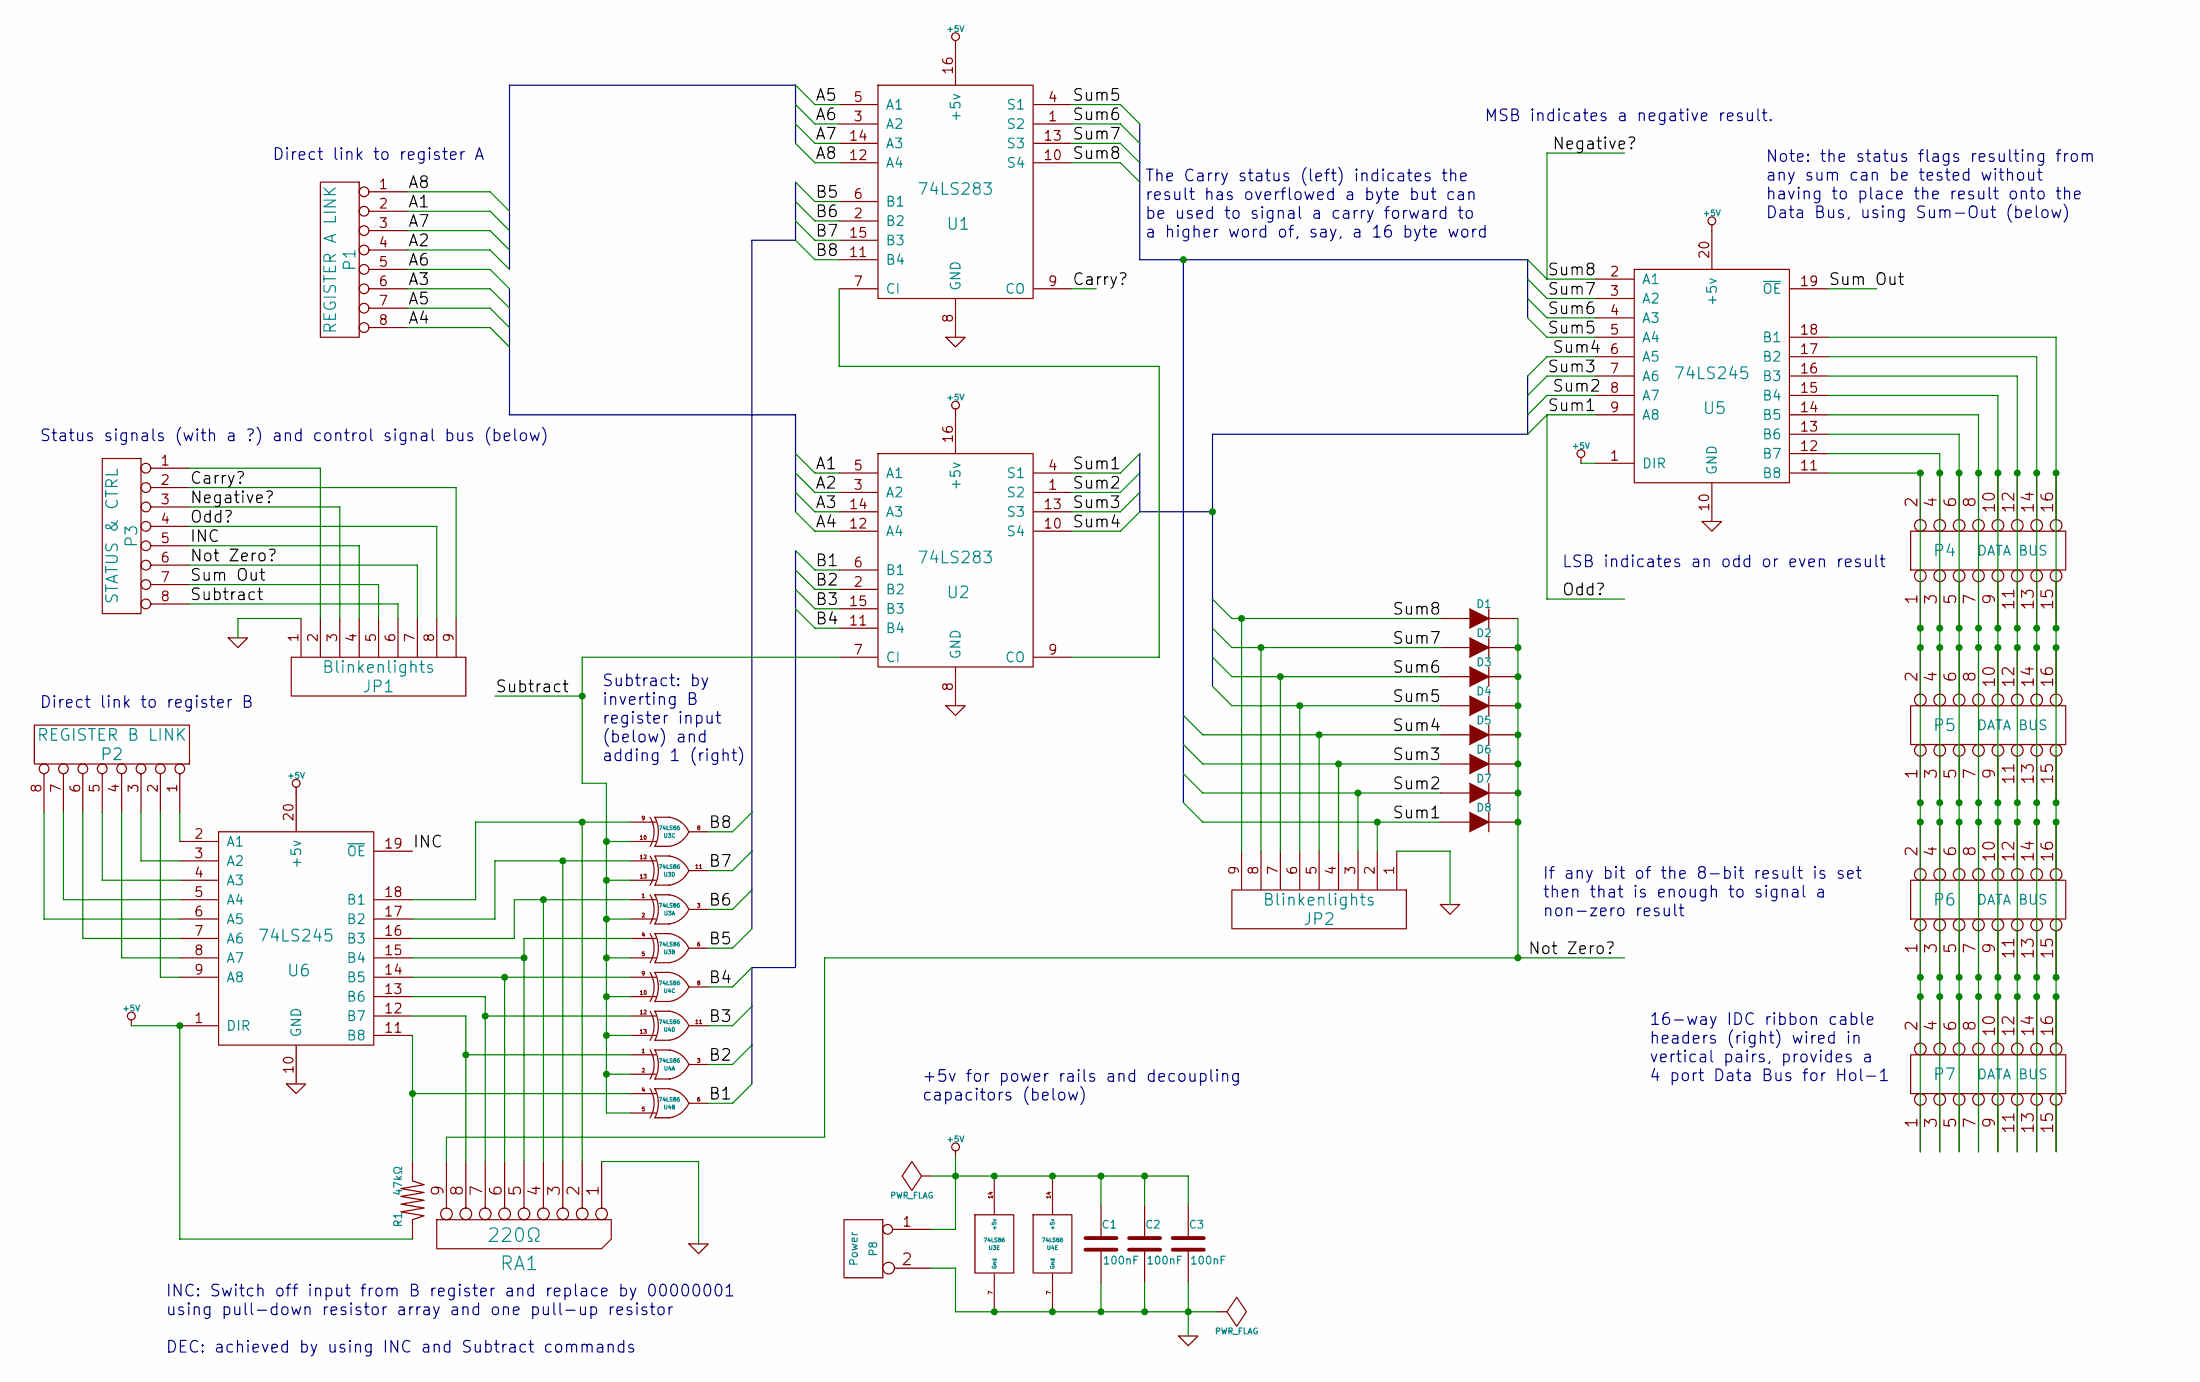
[picture p17: schematic Hol-1-ALU.kicad_sch, Hol-1 8-bit CPU - ALU board]

Parts:
C1, C2, C3: 100nF
D1, D2, D3, D4, D5, D6, D7, D8: DIODE
JP1, JP2: Blinkenlights
P1: REGISTER A LINK
P2: REGISTER B LINK
P3: STATUS & CTRL
P4, P5, P6, P7: DATA BUS
P8: Power
R1: 47kΩ
RA1: 220Ω
U1, U2: 74LS283
U3, U4: 74LS86
U5, U6: 74LS245

Connections:
+5V: C1.1, C2.1, C3.1, P8.1, R1.2, U1.16 (+5v), U2.16 (+5v), U3.14 (+5v), U4.14 (+5v), U5.1 (DIR), U5.20 (+5v), U6.1 (DIR), U6.20 (+5v)
/A1: P1.2, U2.5 (A1)
/A2: P1.4, U2.3 (A2)
/A3: P1.6, U2.14 (A3)
/A4: P1.8, U2.12 (A4)
/A5: P1.7, U1.5 (A1)
/A6: P1.5, U1.3 (A2)
/A7: P1.3, U1.14 (A3)
/A8: P1.1, U1.12 (A4)
/B1: U2.6 (B1), U4.6
/B2: U2.2 (B2), U4.3
/B3: U2.15 (B3), U4.11
/B4: U2.11 (B4), U4.8
/B5: U1.6 (B1), U3.6
/B6: U1.2 (B2), U3.3
/B7: U1.15 (B3), U3.11
/B8: U1.11 (B4), U3.8
/Carry?: JP1.9, P3.2, U1.9 (CO)
/INC: JP1.4, P3.5, U6.19 (~OE)
/Negative?: D1.1 (A), JP1.3, JP2.9, P3.3, U1.10 (S4), U5.2 (A1)
/Not Zero?: D1.2 (K), D2.2 (K), D3.2 (K), D4.2 (K), D5.2 (K), D6.2 (K), D7.2 (K), D8.2 (K), JP1.7, P3.6, RA1.9
/Odd?: D8.1 (A), JP1.8, JP2.2, P3.4, U2.4 (S1), U5.9 (A8)
/Subtract: JP1.6, P3.8, U2.7 (CI), U3.2, U3.5, U3.10, U3.13, U4.2, U4.5, U4.10, U4.13
/Sum2: D7.1 (A), JP2.3, U2.1 (S2), U5.8 (A7)
/Sum3: D6.1 (A), JP2.4, U2.13 (S3), U5.7 (A6)
/Sum4: D5.1 (A), JP2.5, U2.10 (S4), U5.6 (A5)
/Sum5: D4.1 (A), JP2.6, U1.4 (S1), U5.5 (A4)
/Sum6: D3.1 (A), JP2.7, U1.1 (S2), U5.4 (A3)
/Sum7: D2.1 (A), JP2.8, U1.13 (S3), U5.3 (A2)
/Sum Out: JP1.5, P3.7, U5.19 (~OE)
GND: C1.2, C2.2, C3.2, JP1.1, JP2.1, P8.2 (PM), RA1.1 (COM), U1.8 (GND), U2.8 (GND), U3.7 (Gnd), U4.7 (Gnd), U5.10 (GND), U6.10 (GND)
unnamed: U1.7 (CI), U2.9 (CO)
unnamed: RA1.5, U3.4, U6.15 (B4)
unnamed: RA1.7, U4.12, U6.13 (B6)
unnamed: RA1.8, U4.1, U6.12 (B7)
unnamed: R1.1, U4.4, U6.11 (B8)
unnamed: RA1.2, U3.9, U6.18 (B1)
unnamed: P2.1, U6.2 (A1)
unnamed: P2.7, U6.5 (A4)
unnamed: P2.2, U6.9 (A8)
unnamed: RA1.6, U4.9, U6.14 (B5)
unnamed: RA1.4, U3.1, U6.16 (B3)
unnamed: RA1.3, U3.12, U6.17 (B2)
unnamed: P2.8, U6.6 (A5)
unnamed: JP1.2, P3.1
unnamed: P2.3, U6.3 (A2)
unnamed: P2.4, U6.8 (A7)
unnamed: P2.5, U6.4 (A3)
unnamed: P2.6, U6.7 (A6)
unnamed: P4.11, P4.12, P5.11, P5.12, P6.11, P6.12, P7.11, P7.12, U5.16 (B3)
unnamed: P4.13, P4.14, P5.13, P5.14, P6.13, P6.14, P7.13, P7.14, U5.17 (B2)
unnamed: P4.15, P4.16, P5.15, P5.16, P6.15, P6.16, P7.15, P7.16, U5.18 (B1)
unnamed: P4.1, P4.2, P5.1, P5.2, P6.1, P6.2, P7.1, P7.2, U5.11 (B8)
unnamed: P4.3, P4.4, P5.3, P5.4, P6.3, P6.4, P7.3, P7.4, U5.12 (B7)
unnamed: P4.5, P4.6, P5.5, P5.6, P6.5, P6.6, P7.5, P7.6, U5.13 (B6)
unnamed: P4.7, P4.8, P5.7, P5.8, P6.7, P6.8, P7.7, P7.8, U5.14 (B5)
unnamed: P4.9, P4.10, P5.9, P5.10, P6.9, P6.10, P7.9, P7.10, U5.15 (B4)

Notes on the sheet:
INC: Switch off input from B register and replace by 00000001 using pull-down resistor array and one pull-up resistor DEC: achieved by using INC and Subtract commands
If any bit of the 8-bit result is set then that is enough to signal a non-zero result
Direct link to register B
LSB indicates an odd or even result
+5v for power rails and decoupling capacitors (below)
Note: the status flags resulting from any sum can be tested without having to place the result onto the Data Bus, using Sum-Out (below)
Status signals (with a ?) and control signal bus (below)
Direct link to register A
16-way IDC ribbon cable headers (right) wired in vertical pairs, provides a 4 port Data Bus for Hol-1
The Carry status (left) indicates the result has overflowed a byte but can be used to signal a carry forward to a higher word of, say, a 16 byte word
MSB indicates a negative result.
Subtract: by inverting B register input (below) and adding 1 (right)

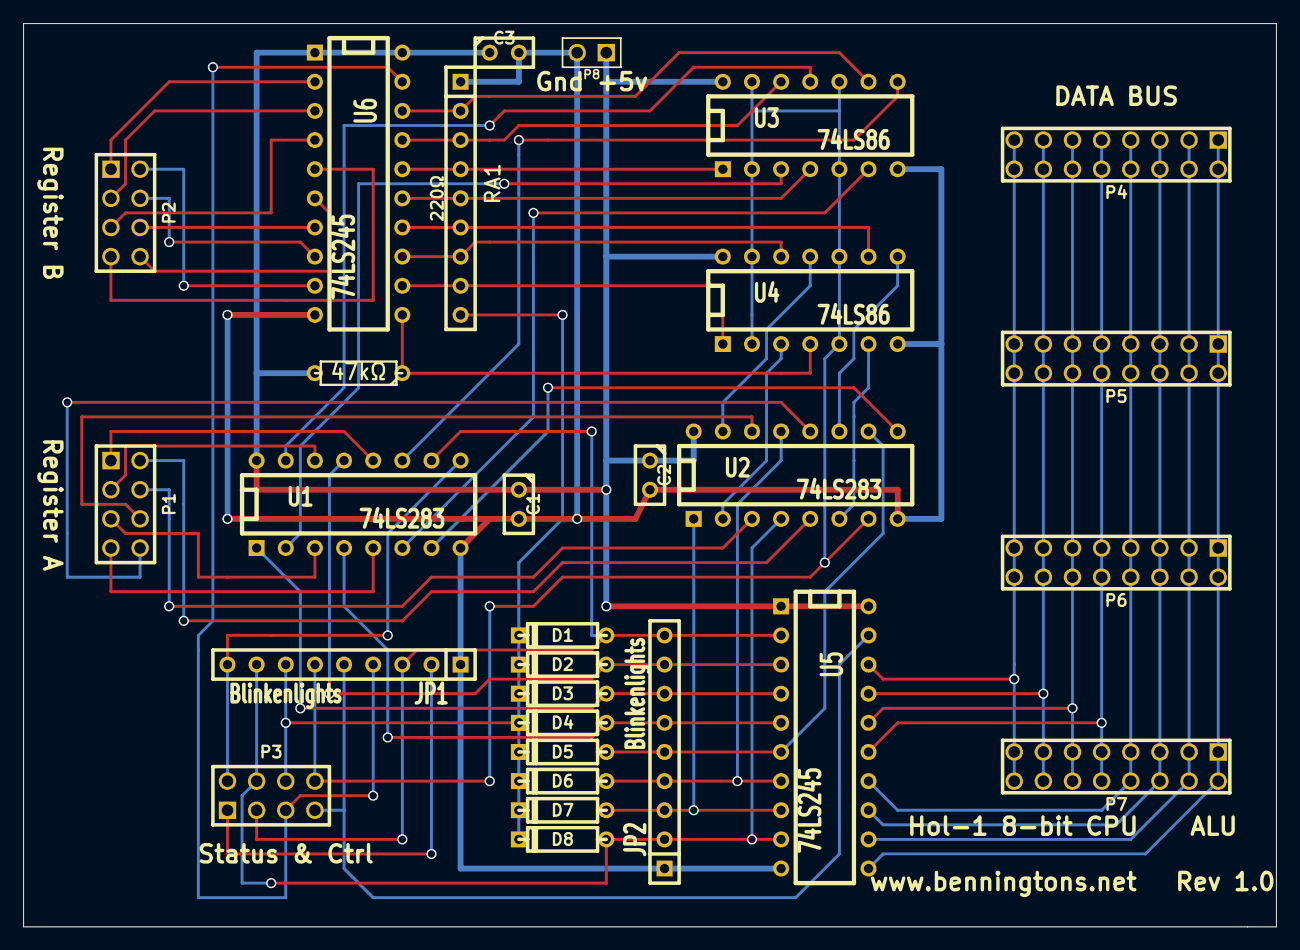
[picture p18: board Hol-1-ALU.kicad_pcb from above]

Board: 2 copper layers, 109.2 x 78.7 mm, 29 parts (0 on the bottom side), 57 nets.
