agben/Hol-1/(commit log)

2019-03-04 v1.0.0 Initiate project with RAM files
    [Hol-1-RAM.kicad_pcb, Hol-1-RAM.sch]
2019-03-04 v1.0.2 reduced RAM board from 31 to 30 rows to match perfboard
    [Hol-1-RAM.kicad_pcb]
2019-03-07 v1.0.3 increased track width for power rails
    [Hol-1-RAM.kicad_pcb]
2019-03-07 v1.0.4 rotated blinkenlight plugin to identify GND
    [Hol-1-RAM.kicad_pcb, Hol-1-RAM.sch]
2019-03-10 v1.1.0 draft ALU schematic added
    [Hol-1-ALU.sch]
2019-03-10 v1.1.1 inserted component library - don't hardlink outside the repo!
2019-03-10 v1.1.2 comments added to schematic
    [Hol-1-ALU.sch, Hol-1-RAM.sch]
2019-03-15 v1.2.0 ALU PCB created
    [Hol-1-ALU.kicad_pcb, Hol-1-ALU.sch]
2019-03-15 v1.2.1 updated schematic and pcb pictures
    [Hol-1-ALU.kicad_pcb, Hol-1-RAM.kicad_pcb]
2019-03-16 v1.2.2 resistor values added to schematic
    [Hol-1-ALU.sch]
2019-03-19 v1.3.0 schematic for registers A, B and C
    [Hol-1-Registers.sch]
2019-03-19 v1.3.1 picture of registers schematic
2019-03-21 v1.3.2 corrected register net names
    [Hol-1-Registers.sch]
2019-03-22 v1.3.3 reduce dip footprints to correct length
    [Hol-1-Registers.sch]
2019-03-23 v1.3.4 Registers PCB
    [Hol-1-Registers.kicad_pcb]
2019-03-23 v1.3.5 Registers PCB image
    [Hol-1-Registers.kicad_pcb]
2019-03-24 v1.3.6 silkscreen IC footprint corrections
    [Hol-1-ALU.kicad_pcb, Hol-1-RAM.kicad_pcb]
2019-03-30 v1.4.0 schematic for clock sources
    [Hol-1-Clock.sch]
2019-03-30 v1.4.1 pcb layout for clock sources
    [Hol-1-Clock.kicad_pcb, Hol-1-Clock.sch]
2019-03-30 v1.4.2 schematic correction for triggering astable clock
    [Hol-1-Clock.sch]
2019-03-31 v1.4.3 added schematic for clock selection
    [Hol-1-Clock.sch]
2019-04-06 v1.4.4 added PCB for clock selection
    [Hol-1-Clock.kicad_pcb, Hol-1-Clock.sch]
2019-04-23 v1.4.5 don't drive an LED directly from the clock output
    [Hol-1-Clock.kicad_pcb, Hol-1-Clock.sch]
2019-07-04 v1.5.0 Memory Management Unit (MMU) schematic first draft
    [Hol-1-Clock.kicad_pcb, Hol-1-MMU.sch]
2019-07-13 v1.5.1 MMU component footprints created
    [Hol-1-MMU.kicad_pcb, Hol-1-MMU.sch]
2019-07-27 v1.5.2 MMU power + blinkenlights added
    [Hol-1-MMU.kicad_pcb, Hol-1-MMU.sch]
2019-07-29 v1.5.3 initial MMU board layout
    [Hol-1-MMU.kicad_pcb, Hol-1-MMU.sch]
2019-07-29 v1.5.4 MMU add bypass caps
    [Hol-1-MMU.kicad_pcb, Hol-1-MMU.sch]
2019-07-30 v1.5.5 MMU reduce vias and tidy-up
    [Hol-1-MMU.kicad_pcb]
2019-07-31 v1.5.6 MMU 10-pin jumpers for hex display blinkenlights
    [Hol-1-MMU.kicad_pcb, Hol-1-MMU.sch]
2019-08-01 v1.5.7 MMU more ergonomic layout for data input
    [Hol-1-MMU.kicad_pcb]
2019-08-02 v1.5.8 MMU added blinkenlights to display memory address register
    [Hol-1-MMU.kicad_pcb, Hol-1-MMU.sch]
2019-08-02 v1.5.9 MMU tie unused inputs to ground
    [Hol-1-MMU.kicad_pcb, Hol-1-MMU.sch]
2019-08-05 v1.5.10 MMU: better space ICs
    [Hol-1-MMU.kicad_pcb]
2019-08-26 v1.5.11 MMU: accommodate larger IDC headers
    [Hol-1-MMU.kicad_pcb]
2019-08-26 v1.5.12 MMU: accommodate larger JST header
    [Hol-1-MMU.kicad_pcb]
2019-09-08 v1.5.13 MMU: adjustments during construction
    [Hol-1-MMU.kicad_pcb, Hol-1-MMU.sch]
2020-01-19 v1.5.14 Registers: Re-numbered A & B ports. ALU to follow
    [Hol-1-Registers.kicad_pcb, Hol-1-Registers.sch]
2020-01-19 v1.5.15 ALU: Re-numbered 8 pin IDC ports to reflect the anti-clockwise numbering used
    [Hol-1-ALU.kicad_pcb, Hol-1-ALU.sch]
2020-01-29 v1.5.16 MMU: don't share a resistor between program and run LEDs
    [Hol-1-MMU.kicad_pcb, Hol-1-MMU.sch]
2020-02-03 v1.5.17 MMU: schematic and pcb layout pictures added
2020-08-15 v1.5.18 upgraded to KiCad 4.0.5
    [Hol-1-ALU.kicad_pcb, Hol-1-ALU.sch, Hol-1-Clock.kicad_pcb, Hol-1-MMU.kicad_pcb, Hol-1-MMU.sch, Hol-1-RAM.kicad_pcb, Hol-1-Registers.kicad_pcb]
2023-06-06 v1.5.19 upgraded to KiCad 5.0
    [Hol-1-ALU.sch, Hol-1-Clock.sch, Hol-1-MMU.sch, Hol-1-RAM.sch, Hol-1-Registers.kicad_pcb, Hol-1-Registers.sch]
2024-05-26 v1.5.20 corrections to remove KiCad rescue libraries
    [Hol-1-ALU.sch, Hol-1-MMU.sch]
2025-11-22 1.5.21 upgraded to KiCad 6.0
    [Hol-1-ALU.kicad_pcb, Hol-1-ALU.kicad_sch]
2025-11-23 v1.5.22 removed pre-KiCad 6.0 file types
    [Hol-1-ALU.sch, Hol-1-Clock.sch, Hol-1-MMU.sch, Hol-1-RAM.sch, Hol-1-Registers.sch]
